Muzhixing/MCU-slave-device/README.md

# 犊牛岛智能投喂车控制工程（main 分支）

## 当前版本说明

`main` 分支目前是 STM32F103C8T6 的正式整合版本。程序已经从地盘、CAN、HWT101、舵机等独立实验入口收拢为单一状态机入口，不再通过宏切换测试程序。

当前版本保留原工程的控制包字段、麦克纳姆轮运动学、航向 PID 公式以及两路步进电机控制参数，并使用已经单独测试过的硬件接线进行整合。

需要特别说明：四路底盘电机、HWT101、舵机、钢丝电机和横杆电机分别完成过单项测试，正式状态机工程也已经通过 Keil 编译，但整车在正式状态机下的联合运行还没有完成实物验证。因此，这个版本是“正式整合与联调起点”，不是最终交付版本。

四路编码器速度 PID 实验仍保存在 `PIDtest` 分支；CAN 专项测试历史保存在 `CANtest` 分支。

## 当前启用的功能

- HC-08 蓝牙串口接收原工程固定 10 字节二进制控制包。
- HWT101 通过 I2C1 读取航向角。
- 四路直流电机采用开环 PWM 驱动，并执行原麦克纳姆轮运动学分解。
- 原 Mulun 航向 PID 输出作为四轮旋转修正量。
- CAN1 驱动两台步进电机：钢丝地址 1，横杆地址 2。
- 钢丝电机上电执行无感归零，程序等待 30 秒后进入正常控制。
- PA7/TIM3_CH2 驱动横向舵机。

当前没有接入正式动作逻辑的部分：

- 水泵和牛奶监测。
- 超声波检测。
- 第二路舵机。
- 原控制包中的 `SW1`、`SW2` 开关字段。

## 上电与状态机流程

正式入口位于 `new_project/User/main.c`，运行以下四个状态：

```text
STATE_INIT
    ↓
初始化蓝牙串口、四路电机、HWT101、舵机和 CAN1
    ↓
配置并使能地址 1 的钢丝步进电机
    ↓
触发钢丝无感归零并等待 30 秒
    ↓
使能地址 2 的横杆步进电机
    ↓
STATE_IDLE
    ↓
读取 HWT101 航向角并等待蓝牙控制包
    ↓
STATE_UART_PARSE
    ↓
解析并执行控制包，然后返回 STATE_IDLE
```

保护逻辑如下：

- 收到第一帧合法控制包之前，四路底盘电机保持停止。
- HWT101 读取失败时，底盘立即停止输出。
- UART、CAN 或初始化过程进入错误状态后，底盘保持停止。
- 当前没有蓝牙控制包超时停车机制；收到控制包后，底盘会持续执行最后一次有效命令。

## 蓝牙串口协议

HC-08 使用 USART2：115200 波特率、8 数据位、无校验、1 停止位。

正式程序只接收原工程固定 10 字节二进制包：

```text
B3 VX VY YAW SERVO LIFT CROSSBAR SW1 SW2 B4
```

| 字节 | 字段 | 当前用途 |
| ---: | --- | --- |
| 0 | `B3` | 固定包头 |
| 1 | `VX` | 底盘前进方向输入 |
| 2 | `VY` | 底盘横移方向输入 |
| 3 | `YAW` | 航向 PID 的绝对目标角度 |
| 4 | `SERVO` | 横向舵机目标角度，程序限幅为 0～180° |
| 5 | `LIFT` | 地址 1 钢丝电机目标位置 |
| 6 | `CROSSBAR` | 地址 2 横杆电机目标位置 |
| 7 | `SW1` | 保留，当前不执行动作 |
| 8 | `SW2` | 保留，当前不执行动作 |
| 9 | `B4` | 固定包尾 |

发送端必须使用 HEX/原始字节模式。例如：

```text
B3 00 00 00 5A 00 00 00 00 B4
```

ASCII 摇杆测试包已经从正式解析流程删除。

## 引脚与接线

### 四路底盘电机

| 电机 | 位置 | PWM | 方向 A | 方向 B |
| --- | --- | --- | --- | --- |
| A | 左前 LF | PA0 / TIM2_CH1 | PB5 | PB12 |
| B | 左后 LB | PA1 / TIM2_CH2 | PB13 | PB14 |
| C | 右前 RF | PA8 / TIM1_CH1 | PB15 | PA4 |
| D | 右后 RB | PA9 / TIM1_CH2 | PB3 | PB4 |

PWM 周期为 999。四路电机当前没有编码器速度闭环，每个轮子的转速差、负载差和机械摩擦不能由底层速度 PID 自动补偿。

### 通信与其他外设

| 功能 | STM32 引脚 | 说明 |
| --- | --- | --- |
| HC-08 | PA2 TX、PA3 RX | USART2，115200，HC-08 TX 接 PA3，RX 接 PA2 |
| HWT101 | PB6 SCL、PB7 SDA | I2C1，100 kHz，器件地址 0x50 |
| CAN1 | PA11 RX、PA12 TX | 必须经过外接 CAN 收发器，不能直接接 CANH/CANL |
| 横向舵机 | PA7 / TIM3_CH2 | 50 Hz，500～2500 us |
| 第二路舵机预留 | PA6 / TIM3_CH1 | 当前不执行动作 |
| SWD | PA13、PA14 | 保留下载和调试 |

HWT101 的 SCL、SDA 需要上拉到 3.3 V。舵机应使用独立 5 V 电源，并与 STM32 共地。CAN 收发器、STM32 和两台步进驱动器必须共地，CANH、CANL 按同名连接；总线两端根据实际拓扑配置 120 Ω 终端电阻。

## 已经完成的单项实验

### 四路底盘电机

- 四台电机均已分别跑通。
- 已完成四路同时正转实验。
- 30% PWM 测试值为 300，PWM 周期为 999。
- 当前正式版本使用开环 PWM，不使用四路编码器速度 PID。

### HWT101

- 已确认 HWT101 可以通过 I2C1 通信。
- 使用 PB6/PB7 读取寄存器 `0x3F` 的两字节航向角数据。
- 当前换算为有符号角度，范围约为 -180°～180°。

### 舵机

- 横向舵机使用 PA7/TIM3_CH2。
- 已实物测试 90°中位、70°和 110°两侧位置，动作正常。

### CAN 步进电机

- 使用外接 CAN 收发器后，横杆和钢丝电机均完成过运动测试。
- 钢丝驱动器地址为 1，横杆驱动器地址为 2。
- 钢丝电机无感归零已经完成实物测试。
- 正式状态机沿用已验证的地址、方向、速度、加速度和归零参数。

## 航向 PID 的真实状态

当前航向 PID 已经接入正式控制链路，但还不能认定为准确、可靠的整车航向闭环。

当前参数保持原工程数值：

```text
Kp = 12
Ki = 2
Kd = 2
积分上限 = 35
输出上限 = 350
积分分离阈值 = 30°
```

已知问题：

1. 数据包中的 `YAW` 是无符号 8 位，只能直接表示 0～255，不能完整表示 -180°～180°或0～359°航向范围。
2. 程序把 `YAW` 当作绝对航向，没有在车辆开始运动时自动锁定当时的 HWT101 航向。
3. PID 的积分和微分公式没有引入采样周期 `dt`，控制效果会随调用频率改变。
4. 没有航向误差死区，也没有对 HWT101 航向数据进行滤波。
5. PID 小角度误差输出可能低于底盘电机实际起转 PWM，表现为小扰动不回正；误差增大后又可能突然产生较大输出。
6. 四个底盘电机是开环控制，轮速不一致会继续影响航向修正效果。
7. 需要通过实车确认 HWT101 正方向和底盘旋转正方向是否一致，否则可能形成正反馈。

因此，当前版本保留了原工程 PID 数据和计算逻辑，方便后续对照调试，但没有把它记录为“航向 PID 已经调试成功”。

## 原协议的限制

- `VX`、`VY` 都是无符号单字节，原生范围为 0～255。
- 电机 PWM 周期为 999，因此控制包直接传递的平移速度最高约为 25.5% PWM。
- 当前协议不能直接表达负的 `VX/VY`，所以不能完整表示后退和反方向横移。
- 停车包如果携带的目标航向与HWT101当前航向不同，航向 PID 仍可能让底盘原地转动。
- `LIFT`、`CROSSBAR` 只有在数值发生变化时才会重新发送 CAN 运动命令。

这些限制来自原工程的数据结构和控制流程。本次整合没有擅自修改协议字段和原控制数据。

## 当前尚未完成的验证

- 正式状态机下的整车联合运行。
- 蓝牙持续控制、断连和控制包超时安全测试。
- 航向 PID 的方向、死区、起转补偿和参数调试。
- 钢丝、横杆和底盘同时运行时的电源与CAN稳定性。
- 长时间运行和异常恢复测试。
- 水泵、牛奶监测、超声波和第二路舵机。

## 编译情况

2026-09-10 使用 Keil MDK ARMCC 5.06 Update 5 对 `new_project/project.uvprojx` 执行全量重新构建：

```text
Program Size: Code=18498 RO-data=310 RW-data=72 ZI-data=2184
0 Error(s), 0 Warning(s)
```

编译成功只证明当前源码可以生成固件，不等于所有模块已经在整车状态下联合测试成功。

## 后续调试顺序

1. 串口输出 `target_yaw`、`current_yaw`、角度误差、PID输出和四轮PWM。
2. 架空底盘，确认HWT101角度正方向与PID旋转修正方向。
3. 解决目标航向的数据范围和初始航向锁定问题。
4. 根据电机实际起转PWM增加死区或起转补偿，再重新调节航向PID。
5. 增加蓝牙控制包超时停车。
6. 完成底盘、舵机、钢丝和横杆的整车联合测试。
7. 最后接入水泵和其他尚未完成测试的外设。

## 工程目录

- `new_project/`：当前 STM32F103C8T6 正式工程。
- `src/`：原工程，用于核对原始逻辑、协议和参数。
- `log/`：每日实验和分支记录。
- `source/`、`new_chap/`：硬件资料、接线图和参考说明。
- `docs/superpowers/`：正式整合设计与执行计划。

Keil 的 `Objects/`、`Listings/` 和构建日志已由 `.gitignore` 排除，不进入 Git 提交。
