Muzhixing/MCU-slave-device/new_project_f407/F407_HAL_Template/docs/hardware/README.md

# 硬件原始资料

- schematic.jpg：用户提供的PCB原理图，接线以网络名核对，不能凭照片颜色判断。
- pcb-front.jpg / pcb-back.jpg：PCB正反面照片。
- fabrication/：原 f407data/牛犊小车 的制板文件及测试网络资料，保持原始内容。
- stepper-menu/：原 pdt 的24张驱动菜单照片，按原文件名排序编号。菜单光标不等于已保存参数；以实机参数为准。

本工程使用脉冲/DIR控制步进电机，不使用CAN。原理图资料与现有实物可能存在装配差异，尤其驱动使能、COM和电源连接应现场确认。水泵未验证工作，不纳入整合功能。
