Muzhixing/MCU-slave-device/docs/superpowers/specs/2026-09-09-original-state-machine-integration-design.md

# 原状态机与已验证硬件整合设计

## 目标

将 `new_project` 从多种实验模式整合为单一正式程序：以原工程状态机和固定 10 字节上位机协议为控制框架，接入新工程已通过实物测试的四路底盘电机、HC-08 UART、CAN 双步进电机及钢丝无感归零功能，并将 HWT101 恢复为原工程 I2C 数据链路。删除新工程中的运行时测试入口和冗余测试代码，但保留有效底层驱动、实验日志、原工程和参考资料。

本次不迁移未经实物验证的硬件参数和动作逻辑。舵机、超声波、水泵和牛奶监测仍属于后续待完成模块，只保留协议字段和状态机扩展位置。

## 范围

### 正式启用的模块

- USART2 + HC-08：接收原始 10 字节二进制控制包。
- I2C1 PB6/PB7：读取 HWT101 地址 `0x50` 的 Yaw 寄存器 `0x3F`。
- 四路直流电机：使用当前已经实物验证的 PWM 通道和方向引脚。
- 麦克纳姆轮运动学：保留原工程四轮分解公式。
- 航向 PID：保留原工程参数、角度归一化、积分分离和输出限幅。
- CAN1 PA11/PA12：500 kbit/s，通过外接收发器连接两台闭环步进驱动器。
- 钢丝电机：地址 1，保留已验证的无感归零和运动协议。
- 横杆电机：地址 2，保留已验证的运动协议。

### 暂不启用的模块

- 超声波液位检测。
- 水泵。
- 牛奶监测及投喂安全联锁。

这些模块的数据字段仍被解析和保存，但不初始化相关外设、不产生硬件动作。状态机保留命名明确的空接口，方便后续逐模块测试后接入。

### 新增实物验证结果（2026-09-10）

- 横向舵机已经完成实物测试，使用 PA7/TIM3_CH2、50 Hz、500~2500 us。
- 正式程序启用横向舵机，固定包中的 `rudder_angle` 直接作为 0~180°目标角度。
- PA6/TIM3_CH1 仅预留给第二路舵机，正式状态机不下发动作。
- 第四路底盘 PWM 已由 PB1 调整为 PA9/TIM1_CH2，并完成编译与独立电机测试程序验证。

### 不进入正式程序的模块

- 编码器底盘闭环。
- 灰度/循迹。
- OLED 显示。
- 独立电机、VOFA、CAN 单次运动及摇杆实验入口。

## 串口控制协议

HC-08 通过 USART2 模拟原上位机，发送固定 10 字节二进制包：

```text
B3 VX VY YAW SERVO LIFT CROSSBAR SW1 SW2 B4
```

| 索引 | 字段 | 当前处理 |
|---:|---|---|
| 0 | `0xB3` | 包头 |
| 1 | `forward_speed` | 更新底盘 `motor_vx` |
| 2 | `horizontal_speed` | 更新底盘 `motor_vy` |
| 3 | `target_angle` | 更新绝对目标航向 `target_yaw` |
| 4 | `rudder_angle` | 控制 PA7/TIM3_CH2 横向舵机，范围限制为 0~180° |
| 5 | `lift_rod` | 字段变化时控制地址 1 钢丝电机 |
| 6 | `horizontal_rod` | 字段变化时控制地址 2 横杆电机 |
| 7 | `switch_one` | 保存，暂不执行 |
| 8 | `switch_two` | 保存，暂不执行 |
| 9 | `0xB4` | 包尾 |

本阶段不改变字段宽度、顺序和原数据含义，不增加校验和，也不把速度字段改为有符号数。ASCII 摇杆包 `[j,LX,LY,RX,RY]` 从正式工程中移除。

## 状态机

正式状态包括：

- `STATE_INIT`
- `STATE_IDLE`
- `STATE_UART_PARSE`
- `STATE_ERROR`

可以保留 `STATE_TASK1`、`STATE_TASK2` 作为后续未完成模块的空扩展点，但它们不产生硬件动作。

### 初始化状态

初始化顺序：

1. 初始化 USART2 和 HC-08 接收中断。
2. 初始化 PB6/PB7 上的 I2C1，并验证 HWT101 地址可应答。
3. 初始化四路底盘 PWM 和方向 GPIO，保持电机停止。
4. 初始化 CAN1、过滤器和接收通知。
5. 初始化双步进电机控制接口。
6. 使用已验证参数启动钢丝无感归零，并保留 30 秒归零等待。
7. 清零底盘速度、目标状态和航向 PID。
8. 进入空闲状态。

初始化失败进入错误状态；错误状态停止四路底盘，并禁止下发新的步进运动命令。

### 空闲状态

空闲状态持续执行以下工作：

1. 检查是否收到完整且合法的 10 字节串口包；有完整包时转入解析状态。
2. 按受控周期读取 HWT101 的 Yaw 寄存器并更新当前角度。
3. 每次成功获得新的 I2C 角度样本后执行一次航向 PID。
4. 使用最新 `motor_vx`、`motor_vy` 和 PID 输出执行四轮麦轮分解。
5. HWT101 地址无应答或寄存器读取失败时停止四轮电机。

I2C 读取使用有限超时，禁止沿用原工程的 `HAL_MAX_DELAY`。读取失败不能返回伪造的 `0°`；必须返回错误状态，由状态机停止底盘。地址、寄存器、字节顺序、角度比例和 PID 数据保持原工程含义。

### 串口解析状态

解析状态完成：

1. 再次验证包头、固定长度和包尾。
2. 复制八个有效字段到正式命令结构体。
3. 更新 `motor_vx`、`motor_vy` 和 `target_yaw`。
4. 仅当 `lift_rod` 与上一条已执行命令不同时，下发地址 1 钢丝命令。
5. 仅当 `horizontal_rod` 与上一条已执行命令不同时，下发地址 2 横杆命令。
6. 将 `rudder_angle` 下发到横向舵机；保存两个开关字段但不产生硬件动作。
7. 返回空闲状态并重新接收下一包。

## 航向控制

删除当前蓝牙实验中的手动旋转状态和以下行为：

```c
target_yaw = current_yaw;
```

正式控制链固定为：

```text
数据包 target_angle
        ↓
绝对 target_yaw
        ↓
HWT101 current_yaw
        ↓
原 Mulun PID
        ↓
旋转修正 omega
        ↓
原麦轮分解
        ↓
四路有符号 PWM
```

PID 参数保持：`Kp=12`、`Ki=2`、`Kd=2`、积分上限 35、输出上限 350、积分分离阈值 30°。

本次不增加最低回正 PWM、不修改PID符号、不修改四轮比例归一化。完成结构整合后，先以抬轮低风险测试确认 HWT101 正方向与实际旋转方向一致，再单独处理电机死区和参数整定。

## 文件调整

### 新增

- `new_project/App/State_Machine.c`
- `new_project/App/State_Machine.h`

### 精简和修改

- `new_project/User/main.c`：删除模式选择，只调用正式状态机。
- `new_project/Hardware/UpperComputer.c/.h`：只保留固定 10 字节协议、正式命令执行和横向舵机字段下发。
- `new_project/Hardware/UART.c/.h`：保留 HC-08 中断接收和必要发送接口。
- `new_project/Hardware/WT101.c/.h`：改为 I2C 寄存器读取，保留原地址、字节顺序和角度换算。
- `new_project/Hardware/Motor.c/.h`：保留实物接线、四轮驱动、麦轮分解和航向 PID 接口。
- `new_project/Hardware/can.c/.h`、`hcan.c/.h`、`Emm_V5.c/.h`、`tower.c/.h`：保留已验证 CAN 和步进协议，移除测试诊断专用接口。
- Keil 工程文件：移除测试源文件，加入正式状态机源文件。

### 从正式新工程删除

- `new_project/App/App_Test.c`
- `new_project/App/App_Test.h`
- `new_project/App/buleteethtest.c`
- `new_project/App/buleteethtest.h`
- `new_project/Tests/`
- `APP_TEST_MODE`、`MAIN_APP_MODE`及其条件编译入口。
- 固定 PWM、VOFA、单电机 PID、CAN 单次运动、ASCII 摇杆等测试逻辑和测试文字输出。

### 明确保留

- `src/` 原工程。
- `log/` 实验记录。
- `source/`、`new_chap/` 接线图、说明书和参考资料。
- 已验证底层驱动。

## 引脚规划

| 功能 | 引脚 |
|---|---|
| HC-08 USART2 | PA2 TX、PA3 RX |
| HWT101 I2C1 | PB6 SCL、PB7 SDA，外接约 4.7 kΩ 上拉到 3.3 V |
| CAN1 | PA11 RX、PA12 TX |
| LF PWM/方向 | PA0；PB5、PB12 |
| LB PWM/方向 | PA1；PB13、PB14 |
| RF PWM/方向 | PA8；PB15、PA4 |
| RB PWM/方向 | PA9；PB3、PB4 |
| 横向舵机 | PA7 / TIM3_CH2 |
| 第二路舵机预留 | PA6 / TIM3_CH1，不下发动作 |

## 安全行为

- 上电和初始化期间四轮保持停止。
- 第一帧有效控制包到达且 HWT101 首次 I2C 读取成功前，不启动底盘。
- HWT101 无应答或寄存器读取失败后停止四轮。
- 非法串口包不覆盖上一条有效命令。
- CAN 初始化失败或归零命令失败时不继续发送步进运动命令。
- 未完成模块不初始化、不动作。

原工程没有通信超时停止策略。本次先保持原数据包的“最后有效命令持续生效”语义，避免蓝牙只发送一次时立即停止；是否增加上位机看门狗作为后续独立安全改动处理。

## 验证

1. 使用临时主机测试验证固定 10 字节包的合法、非法和连续帧解析；测试完成后按需求不把测试目录保留在正式工程。
2. 静态核对原 PID 参数、角度归一化和麦轮公式。
3. 静态核对地址 1 钢丝、地址 2 横杆以及字段变化触发规则。
4. 完整构建 Keil 工程，确认正式源文件列表正确且无测试文件引用。
5. 实物按“串口解析、HWT角度、抬轮PID方向、底盘带载、双步进”顺序验收。
6. 不提交 Keil 中间产物和构建垃圾。

## 完成标准

- 新工程只有一个正式运行入口。
- HC-08 只使用原固定 10 字节协议。
- `target_yaw` 只由数据包 `target_angle` 更新，不被当前角度覆盖。
- 四轮、HWT101、CAN双步进和钢丝归零整合到正式状态机。
- 未完成模块只保留无动作接口。
- 实验入口和冗余测试代码从新工程移除。
- Keil 工程构建通过，并能进入分阶段实物验收。
