Muzhixing/MCU-slave-device/log/20260830.md

# 2026-08-30 工程迁移与 HWT101 调试记录

## 1. 今日工作范围

今天继续在 `E:\project_M\new_project` HAL 工程中进行分阶段移植和硬件验证，原工程 `E:\project_M\src` 继续作为功能与数据逻辑参考，不修改原工程的控制参数和计算逻辑。

本次主要完成和分析的内容包括：

- 核对 HWT101 模块实物、引脚和通信方式；
- 分别测试 HWT101 的 I²C 与 UART 通信；
- 将 HWT101 UART 接收代码接入当前 HAL 测试工程；
- 使用 USART2 将 HWT101 原始数据输出到电脑；
- 分析 WIT 标准通信协议中的发送命令和返回帧；
- 复核新开发板的 USART、I²C、CAN 和板载收发器资源；
- 识别新增照片中的 TJA1050 CAN 总线收发器模块；
- 完成工程构建验证并记录当前硬件故障状态。

## 2. 当前串口资源分配

### 2.1 电脑调试串口

当前继续使用 USART2 作为 USB-TTL 调试输出：

| 功能 | STM32 引脚 | 说明 |
|---|---|---|
| USART2_TX | PA2 | 接 USB-TTL 的 RX |
| USART2_RX | PA3 | 接 USB-TTL 的 TX，可选 |
| RS485-2 DE | PA6 | 输出低电平，禁用板载 RS485 发送 |
| RS485-2 /RE | PA7 | 输出高电平，禁用板载 RS485 接收输出 |

串口参数为：

```text
115200 bps
8 data bits
No parity
1 stop bit
```

### 2.2 HWT101 UART

为了避开开发板 PA9/PA10 上的板载 MAX232 电路，将 USART1 重映射到 PB6/PB7：

| HWT101 | STM32 | 功能 |
|---|---|---|
| VCC | 3.3V | 模块电源 |
| GND | GND | 必须共地 |
| TX | PB7 | USART1_RX |
| RX | PB6 | USART1_TX；只读取时可以暂不连接 |

HWT101 裸板模块对应手册版本为 V23-0705，默认 UART 参数确认为 **115200、8N1**。此前查询到的 9600 bps 参数属于其他封装或型号资料，不适用于当前裸板 HWT101。

## 3. HWT101 UART 测试代码

当前 HAL 工程已经加入 HWT101 UART 原始帧测试：

- 使用重映射 USART1 在 PB7 接收传感器数据；
- 搜索 `0x55` 帧头；
- 每次读取固定 11 字节 WIT 数据帧；
- 对前 10 字节求和并与第 11 字节校验和比较；
- 通过 USART2 将完整原始帧以十六进制输出；
- 接收失败时输出 HAL 状态码。

正常数据示例应类似：

```text
HWT101 UART RAW TEST READY
HWT RAW: 55 52 XX XX XX XX XX XX XX XX XX SUM=OK
HWT RAW: 55 53 XX XX XX XX XX XX XX XX XX SUM=OK
```

其中：

- `55 52` 通常为角速度数据帧；
- `55 53` 通常为角度数据帧；
- `SUM=OK` 表示校验正确；
- `HWT UART ERR=3` 表示 `HAL_TIMEOUT`，即在规定时间内没有收到有效数据。

调整为裸板模块正确的 115200 bps 后，工程已使用 Keil ARMCC 完整重新构建，结果为：

```text
0 Error(s), 0 Warning(s)
```

该结果只能证明代码和工程配置可以正确构建，不能替代传感器实物通信验证。

## 4. WIT 串口协议分析

串口软件中看到的以下数据：

```text
FF AA 27 XX 00
```

是上位机发送给传感器的寄存器读取命令，不是 HWT101 返回的数据：

| 字节 | 含义 |
|---|---|
| FF AA | 上位机命令帧头 |
| 27 | 读取寄存器命令 |
| XX | 要读取的寄存器地址 |
| 00 | 地址高字节 |

例如：

```text
FF AA 27 2E 00
```

表示读取版本号寄存器。传感器正常响应寄存器查询时，应返回以 `55 5F` 开头的 11 字节数据帧。串口工具界面持续显示“发”而没有“收”，说明上位机正在发送查询命令，但没有收到模块响应。

## 5. HWT101 I²C 分析与测试结论

HWT101 同时提供 I²C 接口，引脚为 SCL、SDA、VCC 和 GND。模块 I²C 总线为开漏结构，正常情况下 SCL、SDA 需要通过约 4.7kΩ 电阻上拉至 3.3V。

新开发板默认 I2C1 引脚为：

| 功能 | STM32 引脚 |
|---|---|
| I2C1_SCL | PB6 |
| I2C1_SDA | PB7 |

PB8/PB9 已连接板载 TJA1050 CAN 收发器，不适合继续使用原工程中 I2C1 重映射到 PB8/PB9 的方案。因此本次 I²C 测试改用 PB6/PB7，并检查了硬件上拉、引脚配置、设备地址及寄存器读取流程。

原工程 HWT101 I²C 参数保持为参考：

```text
7位设备地址：0x50
Yaw寄存器：0x3F
I²C速度：100kHz
```

实物测试中仍无法获得正常应答，之前出现的 `HAL_ERROR`、`HAL_BUSY` 或超时均属于通信链路未建立，而不是航向角计算公式问题。

## 6. 当前硬件故障结论

**当前 HWT101 模块出现问题，使用串口和 I²C 都无法进行通信。**

目前已经确认或排查：

- 模块实物为支持 TTL UART 和 I²C 的 HWT101 裸板；
- UART 使用交叉接线，HWT101 TX 接 STM32 RX；
- UART 波特率已按裸板手册改为 115200；
- USART1 已正确重映射到 PB6/PB7；
- I²C 已改用新开发板可用的 PB6/PB7；
- 原工程的 I²C 地址和寄存器逻辑已经核对；
- STM32 工程可以正常构建；
- 上位机能够发送 WIT 查询命令，但没有看到以 `0x55` 开头的传感器返回帧。

因此，当前故障更倾向于以下硬件方向：

1. HWT101 模块供电异常或电源接触不良；
2. 模块 TX 引脚没有输出或模块内部串口状态异常；
3. 模块 I²C 接口损坏或没有正确形成上拉电平；
4. 模块曾被错误供电、反接或受到静电/短路损伤；
5. 当前模块本体已经损坏。

下一步建议直接使用 USB-TTL 单独连接 HWT101，在完全脱离 STM32 的情况下测试 115200 bps 是否存在 `0x55` 返回帧；同时用万用表或示波器检查 VCC、GND、TX 空闲高电平和上电电流。如果独立测试仍无任何返回，应更换一块确认正常的 HWT101 进行对比。

## 7. CAN 收发器模块识别

新增照片中的绿色小板判断为 TJA1050 CAN 总线收发器模块：

- 蓝色两位端子为 CANH/CANL；
- 中间 SOIC-8 芯片为 CAN 物理层收发器；
- 板上 `121` 电阻为 120Ω CAN 终端电阻；
- 四针接口通常为 VCC、TXD、RXD、GND。

该模块用于 MCU CAN 控制器与 CANH/CANL 差分总线之间的物理层转换，不是 USB-TTL、UART 转换器或 RS485 模块，也不能直接用于 HWT101 的 TX/RX 通信。

新 STM32 开发板已经带有 TJA1050 CAN 收发器并占用 PB8/PB9，因此当前方案通常不需要再增加这块外置 CAN 收发器。

## 8. 当前阶段结论

当前阶段已经完成 HWT101 UART 接收代码、原始帧输出、协议格式分析、I²C 与 UART 引脚复核以及工程构建验证。软件侧已经具备继续测试的最小条件，但现有 HWT101 实物在 UART 和 I²C 两种接口下均未建立通信，因此在更换或确认传感器硬件正常之前，不继续迁移 WT101 航向角计算、PID 和整车运动闭环逻辑。

原项目功能和参数继续保留，后续移植仍遵循“每个模块单独测试通过后再进入整合”的原则。
