Muzhixing/MCU-slave-device/log/20260831.md

# 2026-08-31 UART、航向 PID 与蓝牙底盘测试分析记录

## 1. 今日工作范围

今天继续在 `E:\project_M\new_project` HAL 工程中迁移原工程的上位机串口协议、WT101 航向角数据、麦克纳姆轮航向 PID 和四轮运动计算。

本次继续遵循以下约束：

- `E:\project_M\src` 原工程只作为逻辑和数据来源，不修改；
- PID 结构、参数、计算顺序和限幅数据不擅自调整；
- 上位机数据包长度、字段顺序和字段类型保持原样；
- 麦克纳姆轮运动公式保持原样；
- 只对通信接口、目标工程文件组织和新开发板引脚进行 HAL 适配；
- 软件构建通过不能替代 WT101、电机和蓝牙模块的实物测试。

## 2. 当前串口资源分配

### 2.1 上位机及蓝牙串口

上位机或 HC-08 蓝牙串口模块继续复用 USART2：

| 功能 | STM32 引脚 | 连接 |
|---|---|---|
| USART2_TX | PA2 | 接 USB-TTL/蓝牙模块 RX |
| USART2_RX | PA3 | 接 USB-TTL/蓝牙模块 TX |
| RS485-2 DE | PA6 | 保持低电平，禁止板载 RS485 发送 |
| RS485-2 /RE | PA7 | 保持高电平，禁止板载 RS485 接收输出 |

通信参数保持为：

```text
115200 bps
8 data bits
No parity
1 stop bit
```

HC-08 在本次测试中只作为透明串口传输模块，其收发数据与直接使用 USB-TTL 串口等价。

### 2.2 WT101 串口

WT101 继续使用重映射 USART1：

| 功能 | STM32 引脚 | 连接 |
|---|---|---|
| USART1_TX | PB6 | 接 WT101 RX；只读取时可不接 |
| USART1_RX | PB7 | 接 WT101 TX |

通信参数为 115200、8N1，接收固定 11 字节 WIT 数据帧。

## 3. 原上位机串口协议迁移

原工程固定 10 字节二进制数据包保持不变：

```text
B3 forward_speed horizontal_speed target_angle rudder_angle
   lift_rod horizontal_rod switch_one switch_two B4
```

对应结构仍为：

```c
typedef struct
{
    uint8_t header;
    uint8_t forward_speed;
    uint8_t horizontal_speed;
    uint8_t target_angle;
    uint8_t rudder_angle;
    uint8_t lift_rod;
    uint8_t horizontal_rod;
    uint8_t switch_one;
    uint8_t switch_two;
    uint8_t footer;
} UART_Packet_t;
```

USART2 使用接收中断逐字节收集数据，校验包头 `0xB3`、长度 10 和包尾 `0xB4`。解析后仍按原逻辑赋值：

```text
forward_speed    -> motor_vx
horizontal_speed -> motor_vy
target_angle     -> target_yaw
```

舵机、升降杆、水平杆和开关字段继续保留在数据结构中；本阶段只接入底盘控制所需的三个字段，不擅自改变其他字段数值和排列。

## 4. WT101 UART 航向角数据

WT101 角度帧格式为：

```text
55 53 RollL RollH PitchL PitchH YawL YawH VL VH SUM
```

处理流程为：

1. 搜索帧头 `0x55`；
2. 接收完整 11 字节帧；
3. 校验前 10 字节累加和；
4. 只对类型 `0x53` 的角度帧提取 Yaw；
5. 将 `YawL/YawH` 组合成有符号 `int16_t` 原始值；
6. 使用原角度比例换算。

换算公式保持为：

```c
yaw = (float)yaw_raw / 32768.0f * 180.0f;
```

使用 `int16_t` 是为了正确保留 WT101 协议中的负航向角，不改变协议原始数据。

## 5. 原麦克纳姆轮航向 PID 迁移

本次迁移的是原工程 `src\Hardwaer\mulun.c/.h` 中用于四轮底盘航向控制的 PID，不是另一套两轮编码器速度 PID。

PID 结构字段保持为：

```text
integral
last_error
p / i / d
integral_max
output_max
```

所有原始参数保持不变：

| 参数 | 数值 |
|---|---:|
| P | 12.0 |
| I | 2.0 |
| D | 2.0 |
| 积分上限 | 35.0 |
| 输出上限 | 350.0 |
| 积分分离阈值 | 30.0° |

计算流程保持为：

```text
目标角度与当前角度归一化
        ↓
计算 [-180°, 180°] 内的最短角度误差
        ↓
误差小于 30° 时进行积分
        ↓
积分限幅 ±35
        ↓
计算比例、积分和微分项
        ↓
PID 输出限幅 ±350
```

## 6. 原四轮运动计算

原麦克纳姆轮运动公式保持不变：

```c
speed_lf = vx - vy + omega;
speed_rf = vx + vy - omega;
speed_lb = vx + vy + omega;
speed_rb = vx - vy - omega;
```

其中：

- `vx` 控制前进和后退；
- `vy` 控制左右平移；
- `omega` 为航向 PID 产生的旋转修正量；
- 四个轮速继续交给当前已经验证的四路 HAL 电机接口。

该公式本身支持前后、左右、斜向和旋转组合，可以实现 360° 任意方向移动。例如 `vx` 与 `vy` 同时非零时，小车会沿相应斜向运动。

## 7. uint16_t、uint32_t 与 int32_t 决策

原封装函数为：

```c
void mecanum_with_heading_control(uint16_t vx,
                                  uint16_t vy,
                                  float target_yaw,
                                  float current_yaw);
```

`uint16_t` 和 `uint32_t` 都是无符号类型，不能表示后退或反方向平移所需的负速度。将 `uint16_t` 改成 `uint32_t` 不能解决方向问题，负数还可能被转换为很大的正数。

底层函数已经使用正确的有符号类型：

```c
void mecanum_move(int32_t vx, int32_t vy, float omega);
```

因此本次确定：

- 不修改原 PID 结构和运动公式；
- 不将速度改成 `uint32_t`；
- 后续蓝牙测试在独立测试文件中使用 `int32_t vx` 和 `int32_t vy`；
- 独立计算原 PID 输出 `omega` 后，直接调用原 `mecanum_move()`；
- 这样可以保留原工程逻辑，同时完整表达正负运动方向。

## 8. 江协科技蓝牙串口摇杆资料分析

`source\蓝牙串口信息` 中的 README 和截图确认，江协科技蓝牙串口小程序的摇杆使用 ASCII 文本数据包：

```text
[joystick,左摇杆X,左摇杆Y,右摇杆X,右摇杆Y]
```

启用短格式后为：

```text
[j,左摇杆X,左摇杆Y,右摇杆X,右摇杆Y]
```

示例：

```text
[j,0,-100,97,23]
```

数值可以为负数，因此单片机端必须以有符号类型解析。数据包使用 `[` 和 `]` 确定边界，使用逗号分隔字段。

### 8.1 已确定的摇杆功能

根据本次最终要求，摇杆定义为：

| 摇杆数据 | 功能 |
|---|---|
| 左摇杆 X | 左转或右转，并转换为航向 PID 的目标角度变化 |
| 左摇杆 Y | 暂不使用 |
| 右摇杆 X | 左右平移分量 `vy` |
| 右摇杆 Y | 前进/后退分量 `vx` |

控制数据流确定为：

```text
左摇杆 X
    -> 更新 target_yaw
    -> PID_Mulun_Calc(target_yaw, current_yaw)
    -> omega

右摇杆 X/Y
    -> int32_t vy/vx

vx + vy + omega
    -> mecanum_move()
    -> 四轮电机
```

因此：

- 左摇杆负责左右旋转和改变目标航向；
- 右摇杆负责前后、左右以及所有斜向平移；
- 平移过程中仍通过 WT101 和原 PID 修正航向；
- 原麦轮计算可以满足斜向和 360°平移要求；
- 蓝牙模块继续复用 USART2，不新增通信硬件接口。

### 8.2 蓝牙测试文件决策

后续独立测试文件名称按要求确定为：

```text
new_project\App\buleteethtest.c
new_project\App\buleteethtest.h
```

这两个文件当前尚未编写。本次只完成蓝牙资料读取、协议确认、方向映射、PID接入方式和数据类型决策，不能将蓝牙实机控制写成已经测试完成。

## 9. 已完成的软件验证

当前已经加入主机回归测试，逐项确认：

- WT101 `+90°` 和 `-90°` 航向角换算；
- 错误校验和数据帧拒绝；
- PID 的 P/I/D、积分、微分、环绕角度和限幅结果；
- 原 10 字节上位机数据包的所有字段；
- `motor_vx`、`motor_vy` 和 `target_yaw` 的赋值；
- 四轮麦克纳姆运动公式；
- PID 输出正负号进入四轮方向控制；
- UART、WT101、PID 和电机之间的数据调用顺序。

主机测试结果为：

```text
PASS: WT101 conversion and original Mulun PID calculations
PASS: UART and motor migration behavior
PASS: original ten-byte upper-computer UART data flow
PASS: selectable UART and motor application flows
PASS: HWT101 module UART baud is 115200
```

Keil ARMCC 完整构建结果为：

```text
Program Size: Code=11590 RO-data=310 RW-data=28 ZI-data=1972
0 Error(s), 0 Warning(s)
```

链接映射已经确认以下功能实际进入最终固件：

- USART2 中断接收；
- 原 10 字节数据包解析；
- WT101 角度帧解析；
- `PID_Mulun_Init()` 和 `PID_Mulun_Calc()`；
- `mecanum_move()`；
- `mecanum_with_heading_control()`；
- 当前集成控制入口。

## 10. 当前结论与下一步

当前软件已经完成原上位机 UART、WT101 UART 航向角、原航向 PID 和四轮运动计算的迁移，并通过主机数值测试及 Keil 构建验证。原工程 `src` 未修改。

当前尚未完成的实物验证包括：

1. WT101 实际连续返回正确正负航向角；
2. PID 转向方向是否与车体安装方向一致；
3. PID 灵敏度、振荡和超调情况；
4. 四轮同时运行时的斜向轨迹；
5. HC-08 与江协科技小程序的连续摇杆数据接收；
6. `buleteethtest.c/.h` 独立蓝牙测试代码及整车测试。

下一阶段应先实现独立蓝牙测试模式，再按“停车、前后、左右、四个斜向、原地左右转、移动中航向保持”的顺序逐项进行低速实车测试。在获得实车数据前，不调整原 PID 参数。
