Muzhixing/MCU-slave-device/log/20260910.md

# 2026-09-10 实验记录

## HWT101

今天先把 HWT101 改成了 IIC 通信。接线为 PB6-SCL、PB7-SDA，使用 I2C1、100 kHz，读取 0x3F 的航向角数据。串口只负责把读取结果发给蓝牙，不再占用 HWT101 的串口。当前读取流程已经确认可用。

## 四路底盘电机

完成了四路电机 30% PWM 正转测试程序。PWM 周期仍为 999，测试值为 300，不使用编码器 PID，也不启用 HWT101 航向修正。

当前接线如下：

| 电机 | PWM | A 方向 | B 方向 |
| --- | --- | --- | --- |
| A / 左前 | PA0，TIM2_CH1 | PB5 | PB12 |
| B / 左后 | PA1，TIM2_CH2 | PB13 | PB14 |
| C / 右前 | PA8，TIM1_CH1 | PB15 | PA4 |
| D / 右后 | PA9，TIM1_CH2 | PB3 | PB4 |

D 电机 PWM 从原来的 PB1 调整到了 PA9，这样 PA6、PA7 可以完整留给两个舵机。程序已通过主机测试和 Keil 编译；实际装车时仍要再次核对四个轮子的正转方向。

## 舵机测试

单独测试了原工程的横向舵机，不启动电机、CAN 和 HWT101。横向舵机信号接 PA7（TIM3_CH2），保持原工程 50 Hz PWM 和 500~2500 us 脉宽范围。

测试动作循环为：中位 90°、左转 20°（70°）、回中 90°、右转 20°（110°）、回中 90°，每个位置保持 2 秒。

舵机使用独立 5 V 电源，舵机电源地必须和 STM32 的 GND 共地，不能直接使用开发板 3.3 V 给舵机供电。

实物测试已经完成，90°中位、70°和110°两侧动作正常。正式程序使用数据包中的 `rudder_angle` 控制该舵机。

## 正式状态机整合

在上述单项测试基础上开始整合正式程序。主函数不再选择实验模式，只运行 INIT、IDLE、UART_PARSE 和 ERROR 四个状态。蓝牙只接收原来的10字节二进制包；ASCII摇杆实验包已从正式解析流程移除。

钢丝地址1，沿用无感归零参数并等待30秒；横杆地址2。底盘只有在收到第一帧合法控制包且HWT101读取成功后才运行，HWT101读取失败立即停止四轮。D电机最终使用PA9，避免占用CAN的PA11/PA12和舵机的PA6/PA7。
