Muzhixing/MCU-slave-device/log/main.md

# main分支说明

## 当前定位

主分支已由多个互斥实验入口整合为单一正式状态机。代码沿用原工程的10字节上位机数据包、麦克纳姆轮公式、Mulun航向PID和步进运动参数，同时使用新工程已经完成实物测试的引脚与通信方式。

## 已接入功能

- HC-08：PA2/PA3，USART2，115200、8N1。
- HWT101：PB6/PB7，I2C1，地址0x50，Yaw寄存器0x3F。
- 四路开环底盘：PWM PA0、PA1、PA8、PA9。
- CAN双步进：PA11/PA12，500 kbit/s，钢丝地址1、横杆地址2。
- 钢丝上电无感归零：正式控制前等待30秒。
- 横向舵机：PA7/TIM3_CH2，50 Hz，500～2500 us。

## 正式运行逻辑

上电进入`STATE_INIT`，初始化所有已验证外设并保持底盘停止。钢丝归零完成后进入`STATE_IDLE`。串口收到合法的`B3...B4`十字节包时进入`STATE_UART_PARSE`，更新底盘目标、舵机和两路步进命令，再回到空闲状态。

空闲状态每10 ms读取一次HWT101。只有已经收到合法控制包并读取到有效航向角时，才执行原航向PID和麦轮分解。I2C读取失败时四轮立即停止，不使用伪造的0°数据。

## 当前引脚

| 功能 | 引脚 |
| --- | --- |
| 电机A | PA0；PB5、PB12 |
| 电机B | PA1；PB13、PB14 |
| 电机C | PA8；PB15、PA4 |
| 电机D | PA9；PB3、PB4 |
| HC-08 | PA2、PA3 |
| HWT101 | PB6、PB7 |
| 横向舵机 | PA7 |
| 第二路舵机预留 | PA6 |
| CAN1 | PA11、PA12 |

## 尚未完成

超声波、水泵、牛奶监测和第二路舵机没有接入正式动作。相关串口字段可以保留，但当前不会初始化或驱动这些硬件。

`PIDtest`保留四路编码器速度PID实验；`CANtest`保留CAN专项调试历史。
