Muzhixing/MCU-slave-device/log/20260907.md

# 2026-09-07 CAN步进电机测试记录

## 今天完成的内容

今天在 `CANtest` 分支完成了STM32F103C8T6通过外接TJA CAN收发器控制闭环步进电机的测试。横杆电机已经能够通过CAN运动，钢丝升降电机恢复出厂并重新设置后，也完成了地址1、正方向、5 mm低速移动测试。

最后确认CAN物理层、500 kbit/s通信参数、Emm V5协议、钢丝电机地址和毫米到脉冲的换算都能正常配合。当前安全测试程序只启动钢丝电机，不会同时启动横杆。

## 分支和工程范围

- Git分支：`CANtest`
- 分支起点：`ee53ff3`
- 原工程：`src`
- 当前测试工程：`new_project`
- 主控：STM32F103C8T6
- 步进驱动：X42系列闭环驱动板，Emm V5协议
- CAN收发器：外接TJA模块
- 串口：USART2，115200，8N1，用于蓝牙/USB-TTL输出调试信息

这个分支只用于CAN步进电机功能验证，没有改动原工程 `src` 中的运动参数和控制流程。

## 成功时的接线

### STM32与TJA模块

| STM32F103C8T6 | TJA模块 | 说明 |
| --- | --- | --- |
| PA12 / CAN1_TX | TXD | STM32向CAN收发器发送逻辑数据 |
| PA11 / CAN1_RX | RXD | STM32接收CAN收发器输出的数据 |
| 5V | VCC | TJA模块供电 |
| GND | GND | STM32与TJA模块共地 |

### TJA模块与电机CAN模块

| TJA模块 | 电机CAN模块 | 说明 |
| --- | --- | --- |
| CANH | CHAN | CAN高线，模块丝印中的 `CHAN` 按CANH使用 |
| CANL | CHAL | CAN低线，模块丝印中的 `CHAL` 按CANL使用 |

电机驱动器使用自己的动力电源。CANH和CANL使用双绞线连接；总线两端按需要保留120欧终端电阻。不能把PA11、PA12直接接到CANH、CANL，中间必须经过TJA收发器。

### 调试串口

| STM32F103C8T6 | 蓝牙/USB-TTL |
| --- | --- |
| PA2 / USART2_TX | RXD |
| PA3 / USART2_RX | TXD |
| GND | GND |

## 钢丝电机恢复后的驱动器设置

恢复出厂以后先断电重启，再重新执行编码器校准。校准时尽量让电机空载或轻载，避免钢丝被拉紧。

| 菜单项 | 本次设置 | 作用 |
| --- | --- | --- |
| MotType | 1.8° | 对应当前电机和每圈3200脉冲的计算 |
| Cal | 执行一次 | 重新标定编码器和电机参数 |
| P_Pul | PUL_FOC | 闭环FOC控制 |
| P_Serial | CAN1_MAP | 将通信接口设置为CAN |
| En | Hold | 不依赖外部EN引脚，仍可通过协议使能 |
| MStep | 16 | 1.8°电机每圈3200脉冲 |
| MPlyer | Enable | 打开内部细分插补 |
| CAN_Baud | 500000 | 与STM32程序一致 |
| ID_Addr | 1 | 原工程钢丝/升降电机地址 |
| Checksum | 0x6B | 与Emm V5代码一致 |
| Response | Both | 返回接收确认和到位信息 |
| S_Vel_IS | Disable | 速度值不缩小10倍 |
| O_POT_En | Disable | 本次安全测试暂时关闭上电自动回零 |

原工程地址保持为：钢丝升降电机地址1，横杆电机地址2。之前测试中钢丝地址曾设置为3，本次已经重新统一到原工程的地址1。

## CAN配置

STM32时钟为72 MHz，APB1为36 MHz。CAN参数为：

```text
Prescaler = 4
SJW       = 1 TQ
BS1       = 13 TQ
BS2       = 4 TQ
Mode      = Normal
```

CAN位速率计算：

```text
36 MHz / 4 / (1 + 13 + 4) = 500 kbit/s
```

程序使用扩展帧。扩展帧ID由电机地址和分包序号组成：

```text
ExtId = (address << 8) | packet_index
```

钢丝电机地址为1，因此第一帧ID为 `0x100`，第二帧ID为 `0x101`。

## 本次测试数据

本次安全测试调用：

```c
Emm_V5_En_Control(1U, true, false);

Rail_StepMotor_ControlByMM(
    5U,       // 移动5 mm
    1U,       // CAN地址1
    1U,       // 按原工程保留的钢丝正方向
    30U,      // 30 RPM
    5U,       // 加速度档位5
    true,     // 按原工程保留的位置模式标志
    false     // 不等待多机同步
);
```

丝杠参数沿用原工程：

```text
每圈脉冲数 = 3200
丝杠导程   = 4 mm/圈
每毫米脉冲 = 3200 / 4 = 800
5 mm脉冲数 = 5 × 800 = 4000 = 0x00000FA0
```

### 使能命令

Emm V5完整命令：

```text
01 F3 AB 01 00 6B
```

经过当前CAN分包后：

```text
扩展ID 0x100，DLC 5
数据 F3 AB 01 00 6B
```

### 5 mm位置命令

Emm V5完整命令：

```text
01 FD 01 00 1E 05 00 00 0F A0 01 00 6B
```

字段说明：

```text
01          地址1
FD          位置模式功能码
01          方向1
00 1E       速度30 RPM
05          加速度5
00 00 0F A0 脉冲数4000
01          原工程位置模式标志
00          不使用多机同步触发
6B          固定校验字节
```

经过当前CAN分包后：

```text
扩展ID 0x100，DLC 8，数据 FD 01 00 1E 05 00 00 0F
扩展ID 0x101，DLC 5，数据 FD A0 01 00 6B
```

## 代码对应关系

- `new_project/User/main.c`：钢丝电机上电安全测试入口，只发送一次5 mm命令。
- `new_project/Hardware/can.c`：CAN1初始化，PA11/PA12，500 kbit/s。
- `new_project/Hardware/hcan.c`：CAN过滤、接收、扩展帧ID和Emm命令分包发送。
- `new_project/Hardware/Emm_V5.c`：保留原Emm V5使能、位置、停止和回零命令格式。
- `new_project/Hardware/tower.c`：保留原工程毫米到脉冲的换算。
- `new_project/Hardware/UpperComputer.c`：保留原上位机字段到横杆、升降电机命令的映射。
- `new_project/Tests/test_can_stepper_motion.c`：检查原工程两个电机的地址、方向、速度、加速度和脉冲数没有改变。

## 实验结果

1. 钢丝电机恢复出厂后，仅恢复CAN波特率和地址还不够，必须重新选择电机类型并执行 `Cal` 校准。
2. 配置 `P_Serial=CAN1_MAP`、`CAN_Baud=500000`、`ID_Addr=1`、`Checksum=0x6B` 后，钢丝电机能够接收当前工程的CAN命令。
3. 本次地址1、方向1、30 RPM、加速度5、5 mm移动测试成功。
4. 原工程的丝杠换算 `800脉冲/mm` 与驱动器1.8°、16细分设置匹配。
5. 外接TJA收发器使用PA11/PA12可以正常工作，证明之前的问题不在Emm V5运动数据本身，而在CAN物理层、驱动器通信映射或恢复后的参数没有统一。
6. 当前仍关闭上电自动回零。以后恢复自动回零前，需要单独确认回零方向、机械端点以及无感回零的电流和时间阈值，不能直接使用未经验证的数值。

## 当前状态

当前程序适合作为钢丝电机恢复设置后的安全验收程序。确认5 mm重复运动和方向完全正确后，再把测试速度恢复到原工程的100 RPM，并重新接入横杆地址2和上位机控制流程。
