Muzhixing/MCU-slave-device/new_project_f407/README.md

唯一工程入口：[F407_HAL_Template/README.md](F407_HAL_Template/README.md)。
