Muzhixing/MCU-slave-device/source/蓝牙串口信息/readme.txt

摇杆
摇杆可在用户拖动操作后，向蓝牙串口模块发送规定的数据包，用于设备操控、小车遥控等功能。
点击右上角的“编辑”按钮，可以配置摇杆功能。在编辑状态下，点击指定摇杆，可以弹出指定摇杆的配置窗口，在此窗口中，可以配置摇杆的多项信息，具体如下：
形状样式：可设置为圆形或方形。两者的区别是：方形摇杆可以在横向和纵向同时达到最大值而圆形摇杆不行，但圆形摇杆可以保证任何方向摇杆值与原点之间的最大距离相同。
横向最大值：用于修改摇杆横向滑到最大处的摇杆值。
横向步距：用于修改摇杆横向滑动的步距。
纵向最大值：用于修改摇杆纵向滑到最大处的摇杆值。
纵向步距：用于修改摇杆纵向滑动的步距。
配置好摇杆后，在滑动摇杆时，相应的数据包就会发送至蓝牙串口模块，发送信息会显示在“发送信息展示区”。此处目前仅支持以规定的数据包格式进行发送，即：[joystick,左摇杆横向值,左摇杆纵向值,右摇杆横向值,右摇杆纵向值]，值的范围取决于对应摇杆的配置。例如：[joystick,0,100,-50,0]，表示左侧摇杆横向值为0，纵向值为100，右侧摇杆横向值为-50，纵向值为0。
数据包支持使用短格式，若在设置中勾选“数据包使用短格式”，则：“joystick”替换为“j”。
摇杆向右或向上滑动时，值为正，向左或向下滑动时，值为负。若摇杆设置中的“横向最大值”或“纵向最大值”设置为负数，则可以反转值的极性。
滑动摇杆时，数据包每隔一段时间（由设置里的数据包发送间隔指定）发送一次，避免发送过快，导致接收方处理不过来。
数据包解析方法
单片机端作为接收方，需要对数据包进行解析，才能拿到指定的数据。接收数据包时，可以通过“[”和“]”确定数据包的开始和结束，得到方括号内的字符串。随后解析字符串，使用strtok函数可以用逗号分割字符串，使用strcmp函数可以判断字符串是否相等，使用atoi或者atof函数可以把字符串形式的数值转换为变量形式。
