Muzhixing/MCU-slave-device/new_project_f407/F407_HAL_Template/firmware/README.md

# 固件发布文件

本目录HEX由本工程2026-10-26清理后全量Rebuild生成。校验见SHA256SUMS，构建日志见../docs/validation/build.log。
目标STM32F407VET6，HSE8MHz，Keil ARMCC5。未在此次整理中烧录。
重新修改源码后应重新构建、复测并更新本目录与校验；不能把旧发布HEX当作最新源码结果。
