Muzhixing/MCU-slave-device/source/STM32F103C8T6D485-1.pdf

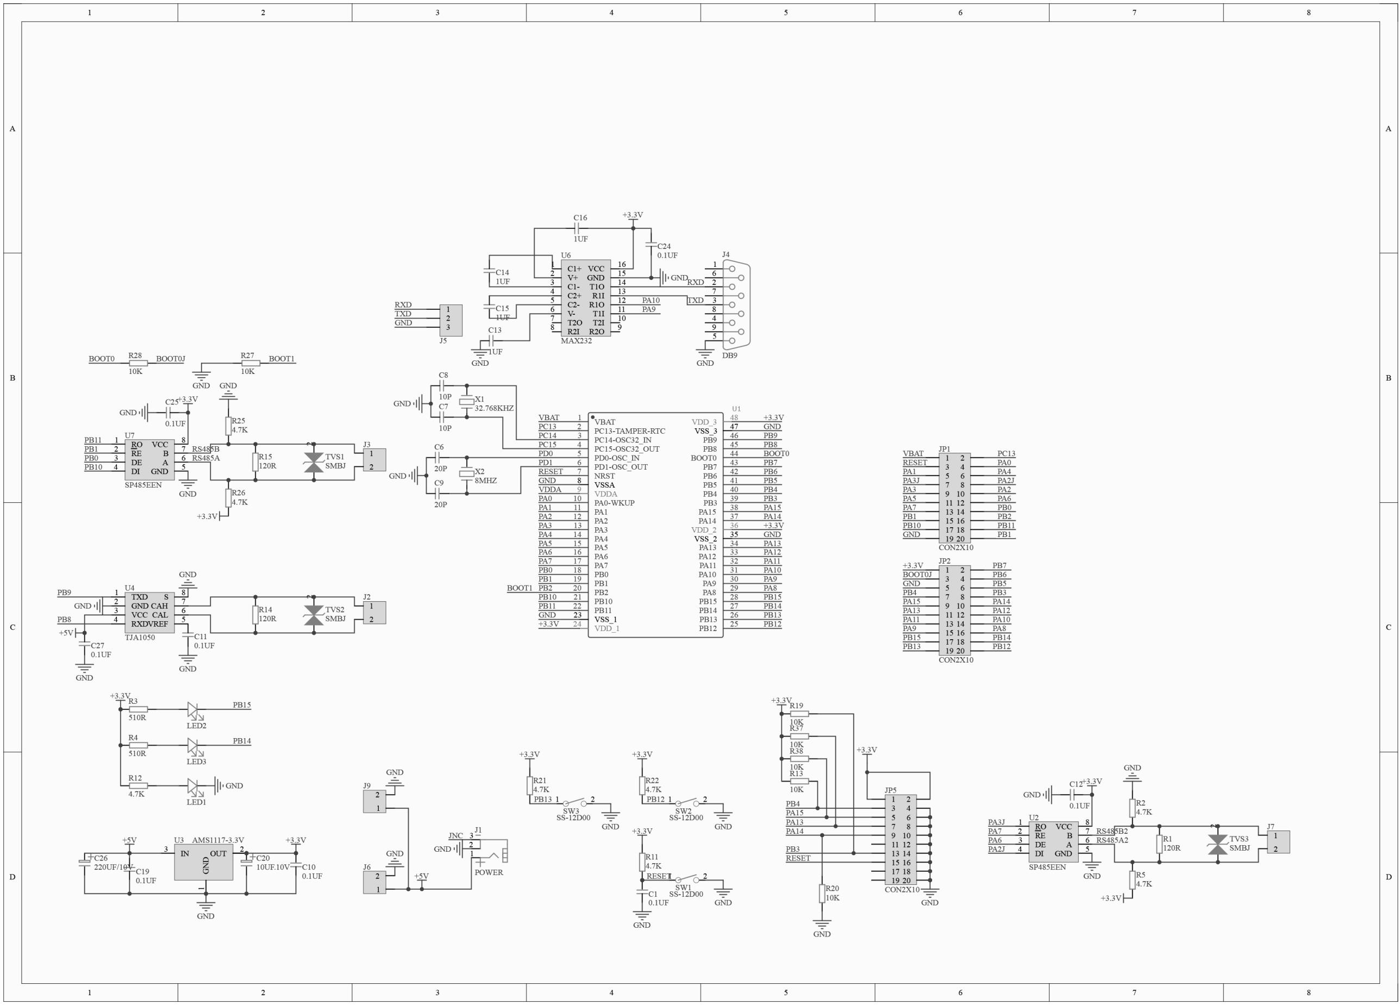
[picture p3: page 1]
