Muzhixing/MCU-slave-device/source/原理图/STM32F103C8T6D485-1.pdf

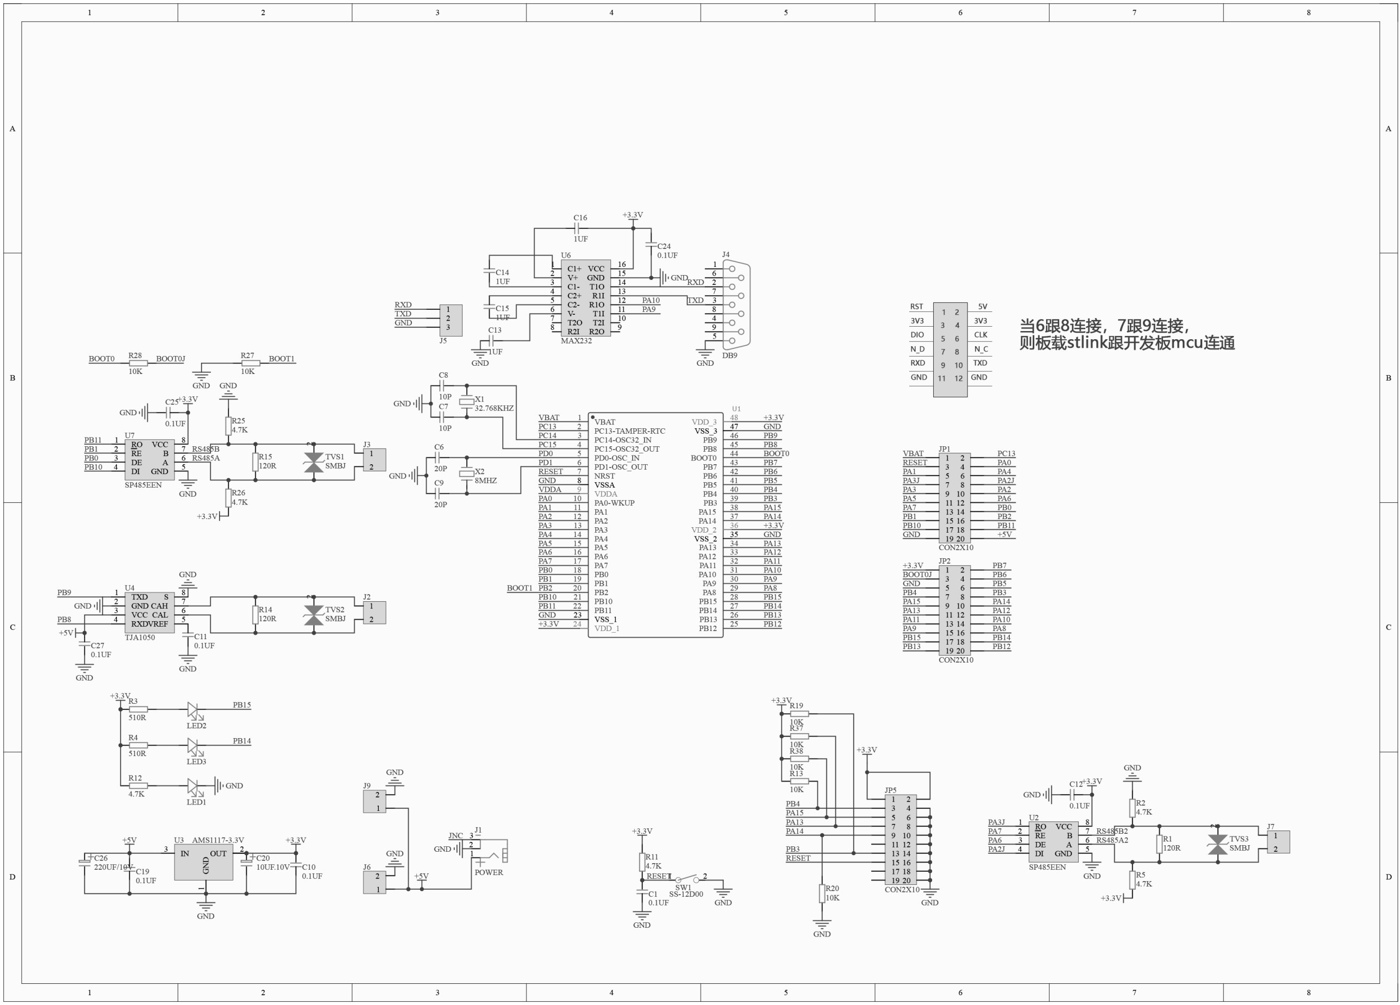
[picture p4: page 1]
