Muzhixing/MCU-slave-device/new_project_f407/F407_HAL_Template/docs/hardware/stepper-menu/20.jpg

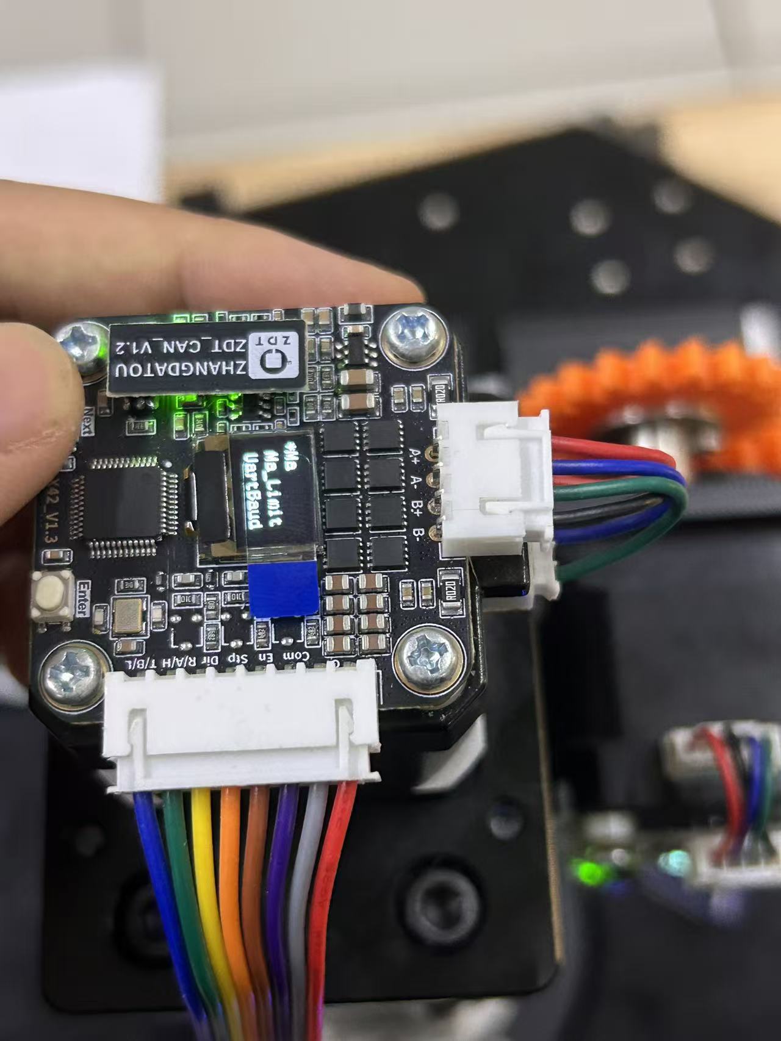
new_project_f407/F407_HAL_Template/docs/hardware/stepper-menu/20.jpg
