Muzhixing/MCU-slave-device/source/D24A.png

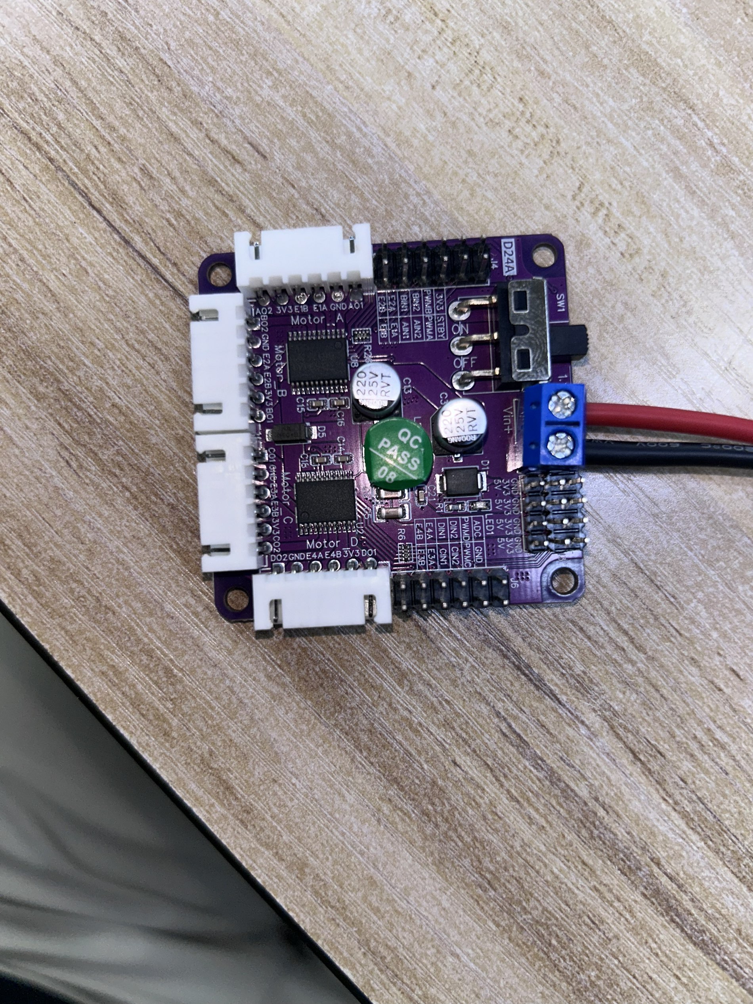
source/D24A.png
