Muzhixing/MCU-slave-device/source/HWT101.jpg

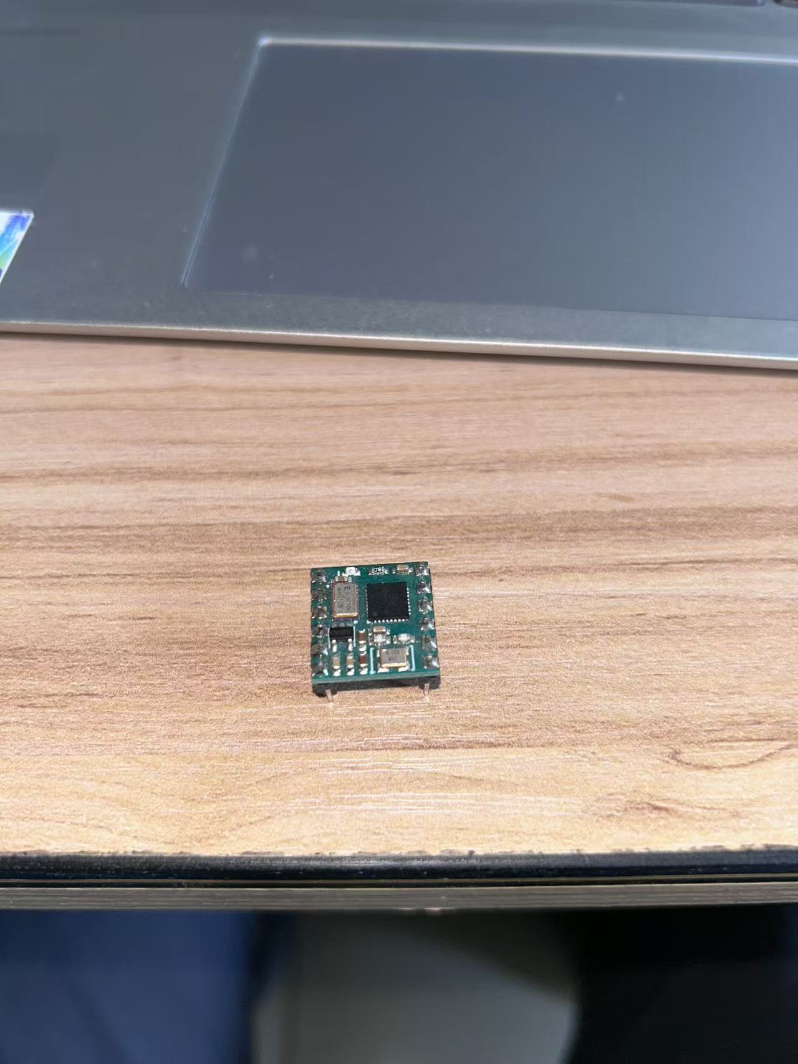
source/HWT101.jpg
