Muzhixing/MCU-slave-device/source/HWT101B.jpg

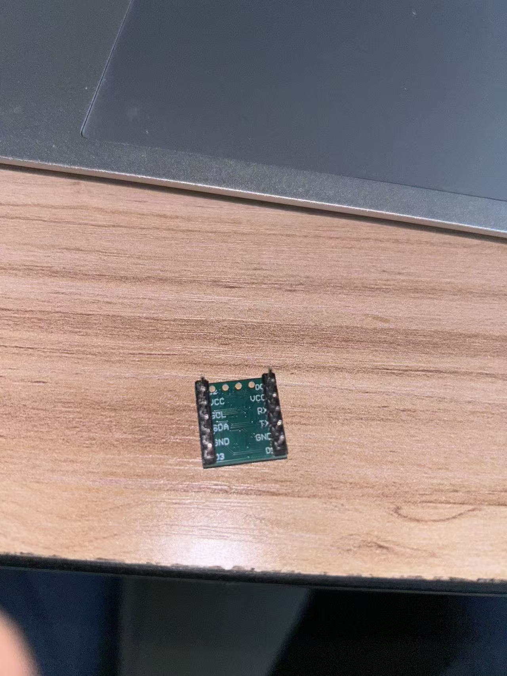
source/HWT101B.jpg
