Muzhixing/MCU-slave-device/source/motor.png

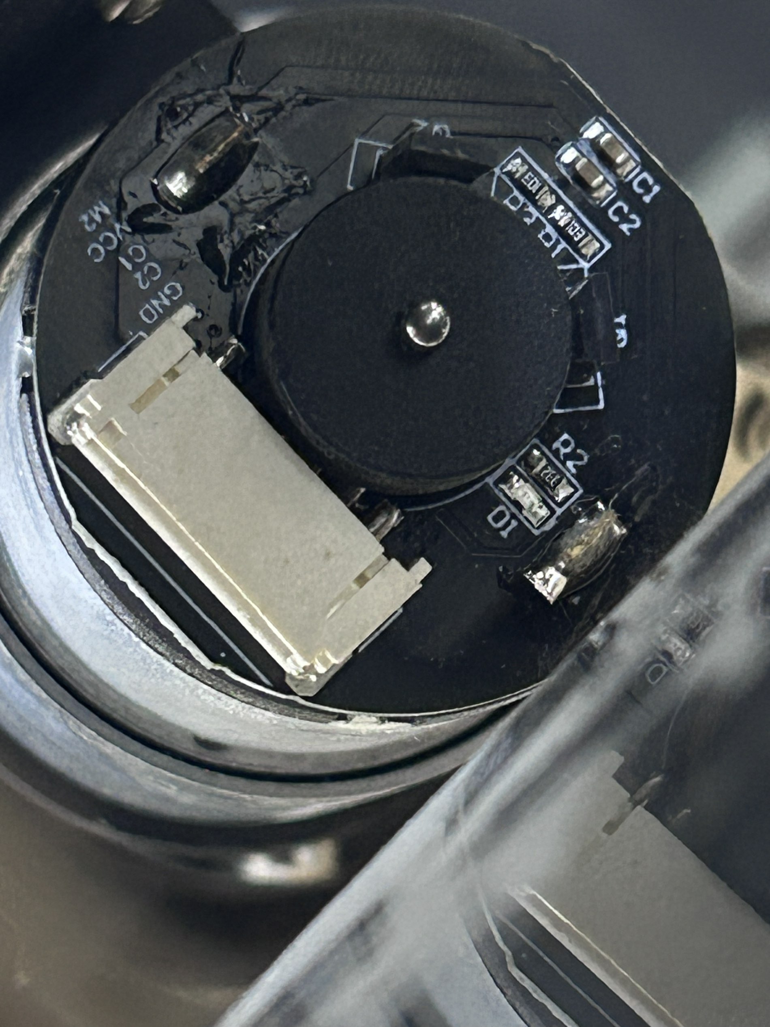
source/motor.png
