Muzhixing/MCU-slave-device/source/stm32c8t6.png

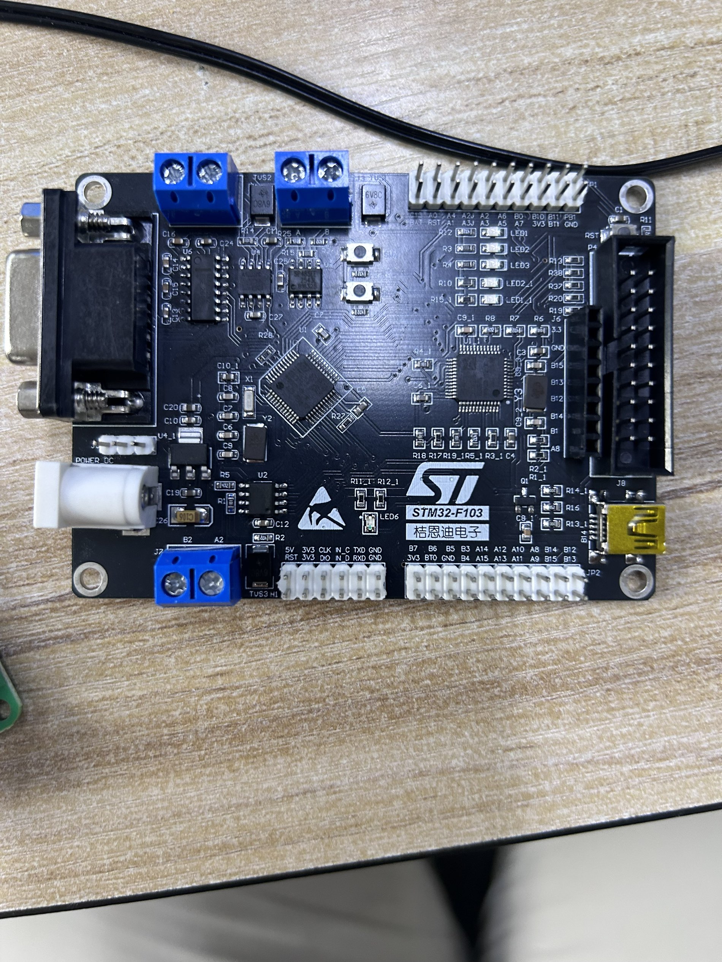
source/stm32c8t6.png
