Muzhixing/MCU-slave-device/source/tupai.jpg

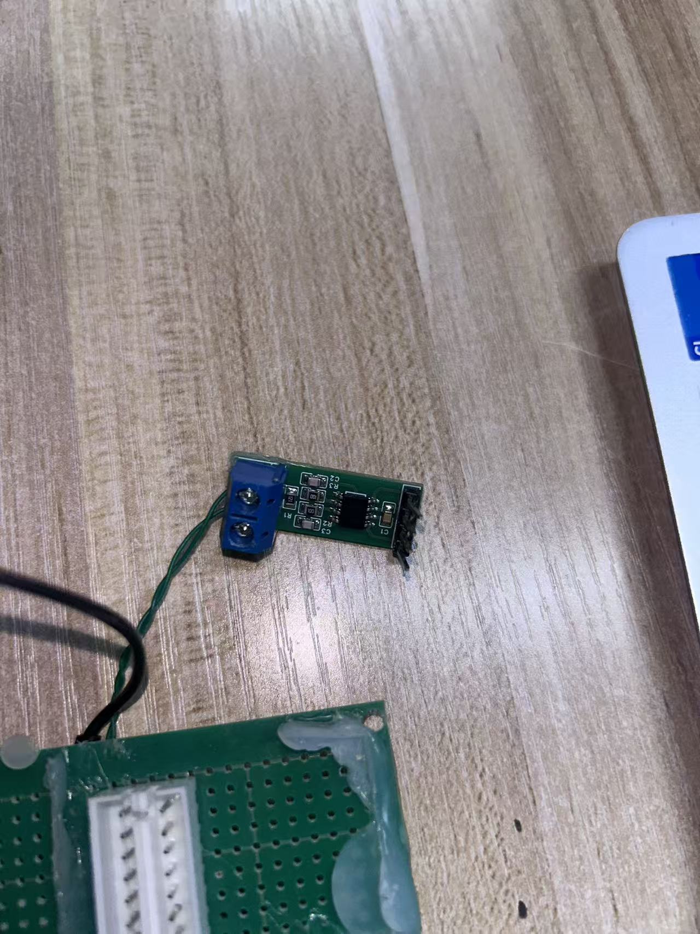
source/tupai.jpg
