Muzhixing/MCU-slave-device/source/上位机.png

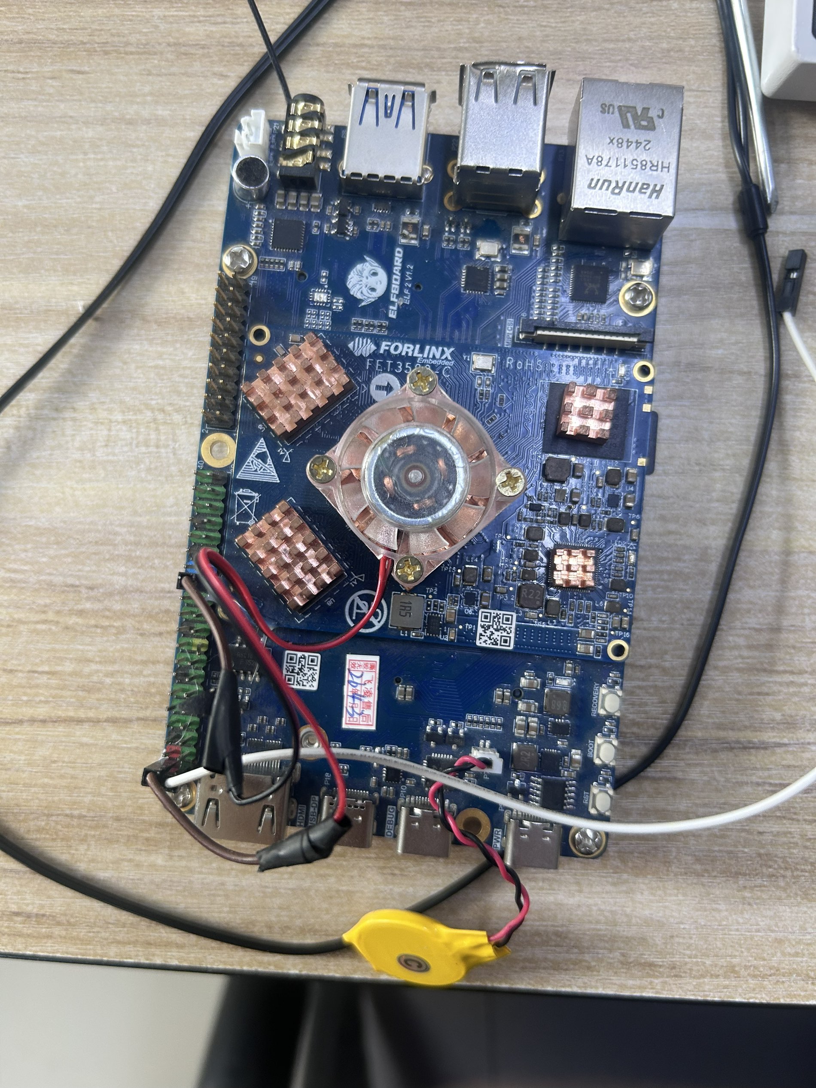
source/上位机.png
