Muzhixing/MCU-slave-device/source/蓝牙串口信息/00e46cf16b4b5d86f79c88b318b47ef7.jpg

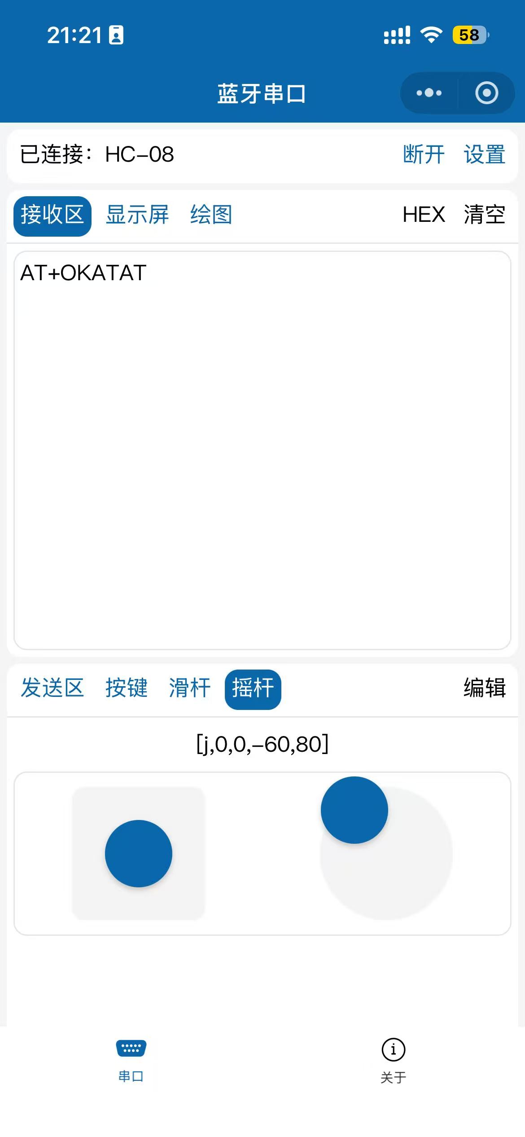
source/蓝牙串口信息/00e46cf16b4b5d86f79c88b318b47ef7.jpg
