Muzhixing/MCU-slave-device/source/蓝牙串口信息/9a2561da734351ed37ddf195a6f66786.jpg

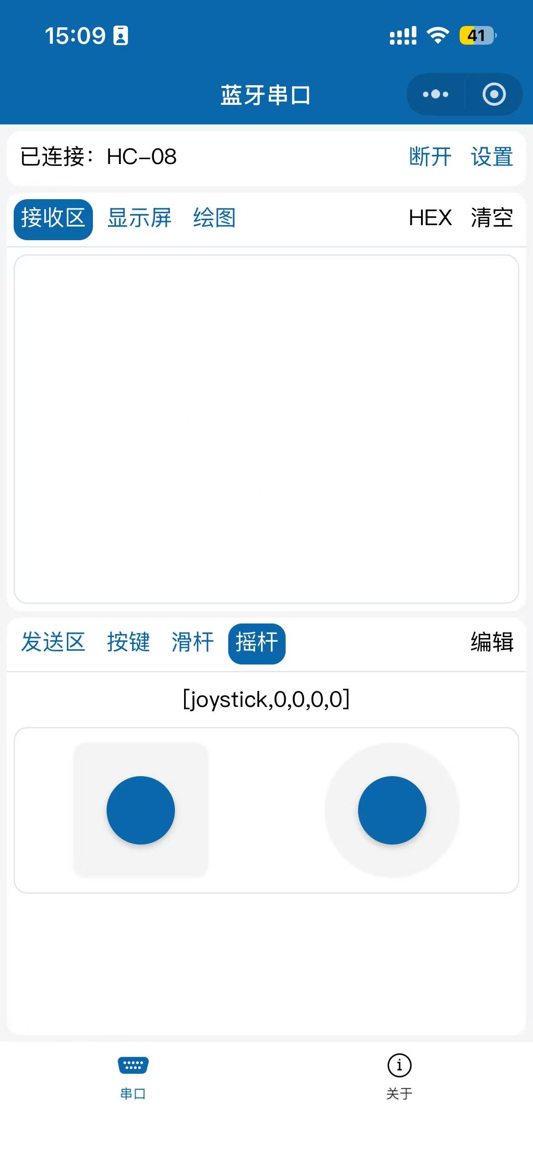
source/蓝牙串口信息/9a2561da734351ed37ddf195a6f66786.jpg
