Muzhixing/MCU-slave-device/source/蓝牙串口信息/42b49e189cae356d66ca0799c48181c1.png

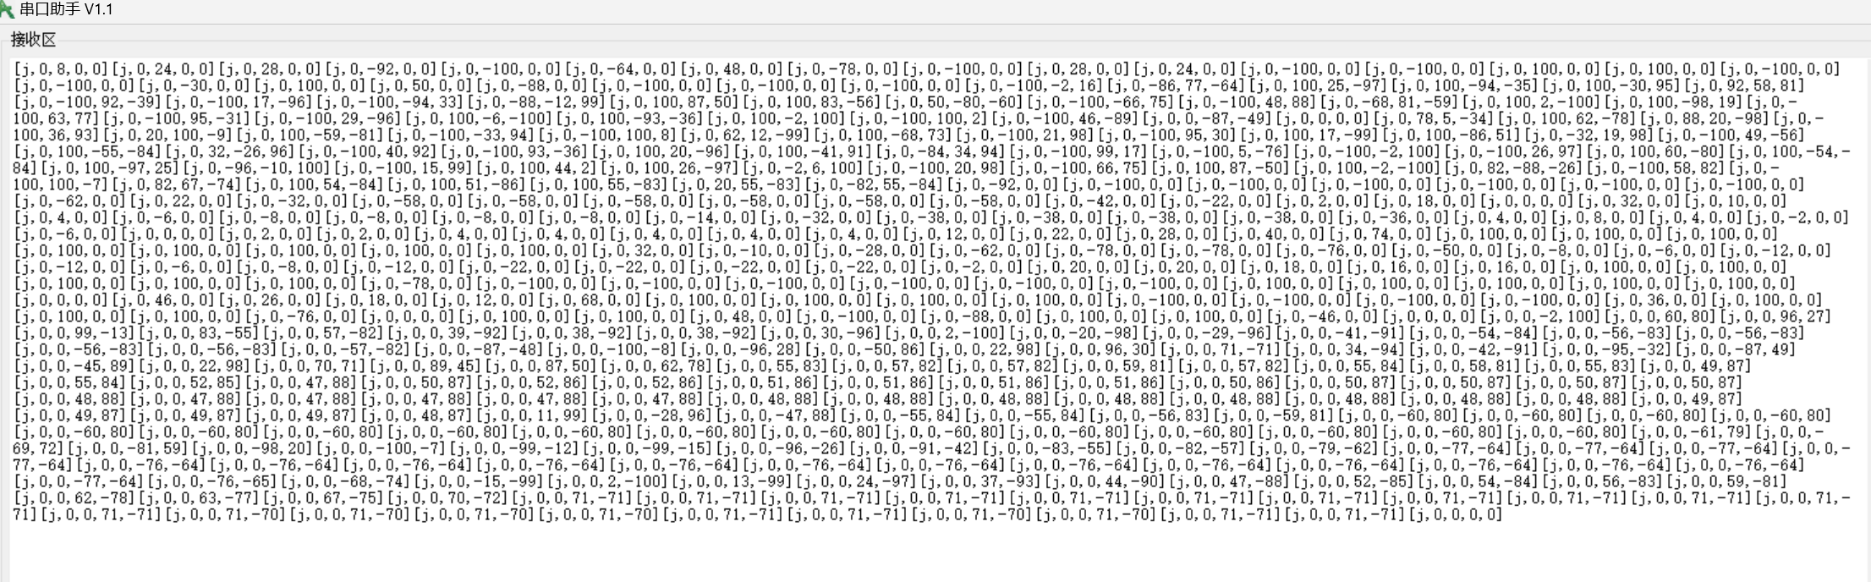
source/蓝牙串口信息/42b49e189cae356d66ca0799c48181c1.png
