Muzhixing/MCU-slave-device/source/蓝牙串口信息/d82d04c01185371e8665aecb59ed1f2d.jpg

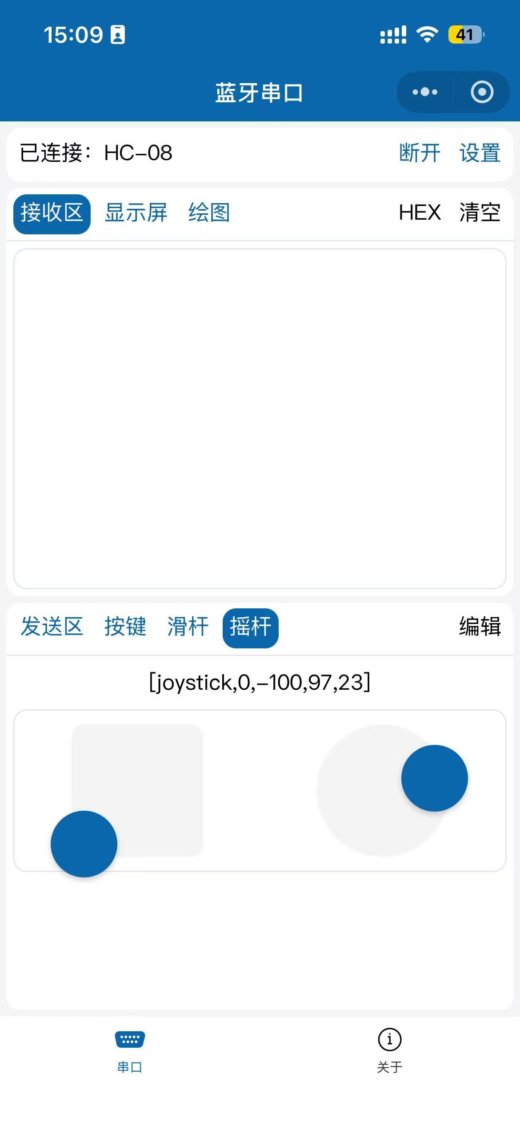
source/蓝牙串口信息/d82d04c01185371e8665aecb59ed1f2d.jpg
