Muzhixing/MCU-slave-device/source/word(3).xlsx

名称 | 价格 | 总计
无声轻触按键（10只） | 2.74
USB3.1 | 2.43
M3*10（100只） | 3.52
TB6612FNG | 6.51
M4*25（20只） | 3.21
6P单排（20只） | 2.71
UMW/友台 LM2596S-5.0V TO263-5 | 3.4
6p弯针+端子+插座（50套） | 8.2
金属齿轮升级款舵机 MG90S（90-180自由角度 | 15.86
2p直针+端子+插座（50套） | 2.82
阻燃宽19mm*厚0.3mm*15米 | 5.07
M3*6带垫螺丝（100只） | 3.35
4P单排（20只） | 2.32
HLK-B0303S-1WR3【3.3V转3.3V】高效率/短路保护 | 4.84
25P双排（5只） | 2.12
3P双排（20只） | 2.71
8P单排（20只） | 3.03
0630电感33UH 印字330（5只） | 2.7
M4*10（20只） | 2.81
3V有源小型一体0905电磁式（2只） | 2.31
4P双排（20只） | 2.93
1N5824贴片SMA丝印SS54（10只） | 2.01
M3*17 (50个) | 8.5
M3*55 (20个) | 14.7
石英晶振32.768M（10个） | 5.14
120Ω;±1%;50只 | 1
TYPE-C-31-M-12 | 3.5
B0524S-1WR3 | 2.6
CH340E MSOP-10 | 2.4
STM32F103RET6 | 15
贴片 TJA1050T/CM | 2.99
XT60PW-F（母头） | 2.7
800mAh 45C【升级款】;3S【XT60插 | 49.3
双模天线SMA | 8
 | 203.43
 | 203.43-30=173.43‬
