Muzhixing/MCU-slave-device/new_project_f407/F407_HAL_Template/docs/validation/host-tests.txt

PASS packet framing/encoding/resync, independent origins, repeated targets, axis/chassis sequencing, yaw hold/correction, reverse brake, disable, sensor/comms/motor faults, telemetry checksum
