Muzhixing/MCU-slave-device/new_project_f407/F407_HAL_Template/docs/validation/README.md

# 2026-10-26 清理后验证

- Keil ARMCC 5.06u5 build528 全量Rebuild：0错误、0警告。
- Code=17588，RO=564，RW=184，ZI=6968字节。
- Keil工程XML及全部文件引用存在、无重复路径。
- GCC C99 `-Wall -Wextra -Werror`：协议/状态机/脉冲模块主机回归通过。
- 测试覆盖解析重同步、有符号编码、零点门控、重复绝对目标、轴/底盘互斥、航向保持、反向等待、停止和故障回报。

详见build.log和host-tests.txt。没有执行本次清理版的硬件烧录或实机回归；用户已确认的是清理前整合数据包成功。固件见../../firmware，SHA256与发布文件一致。
