Muzhixing/MCU-slave-device/source/STM32F103C8T6D485-2.pdf

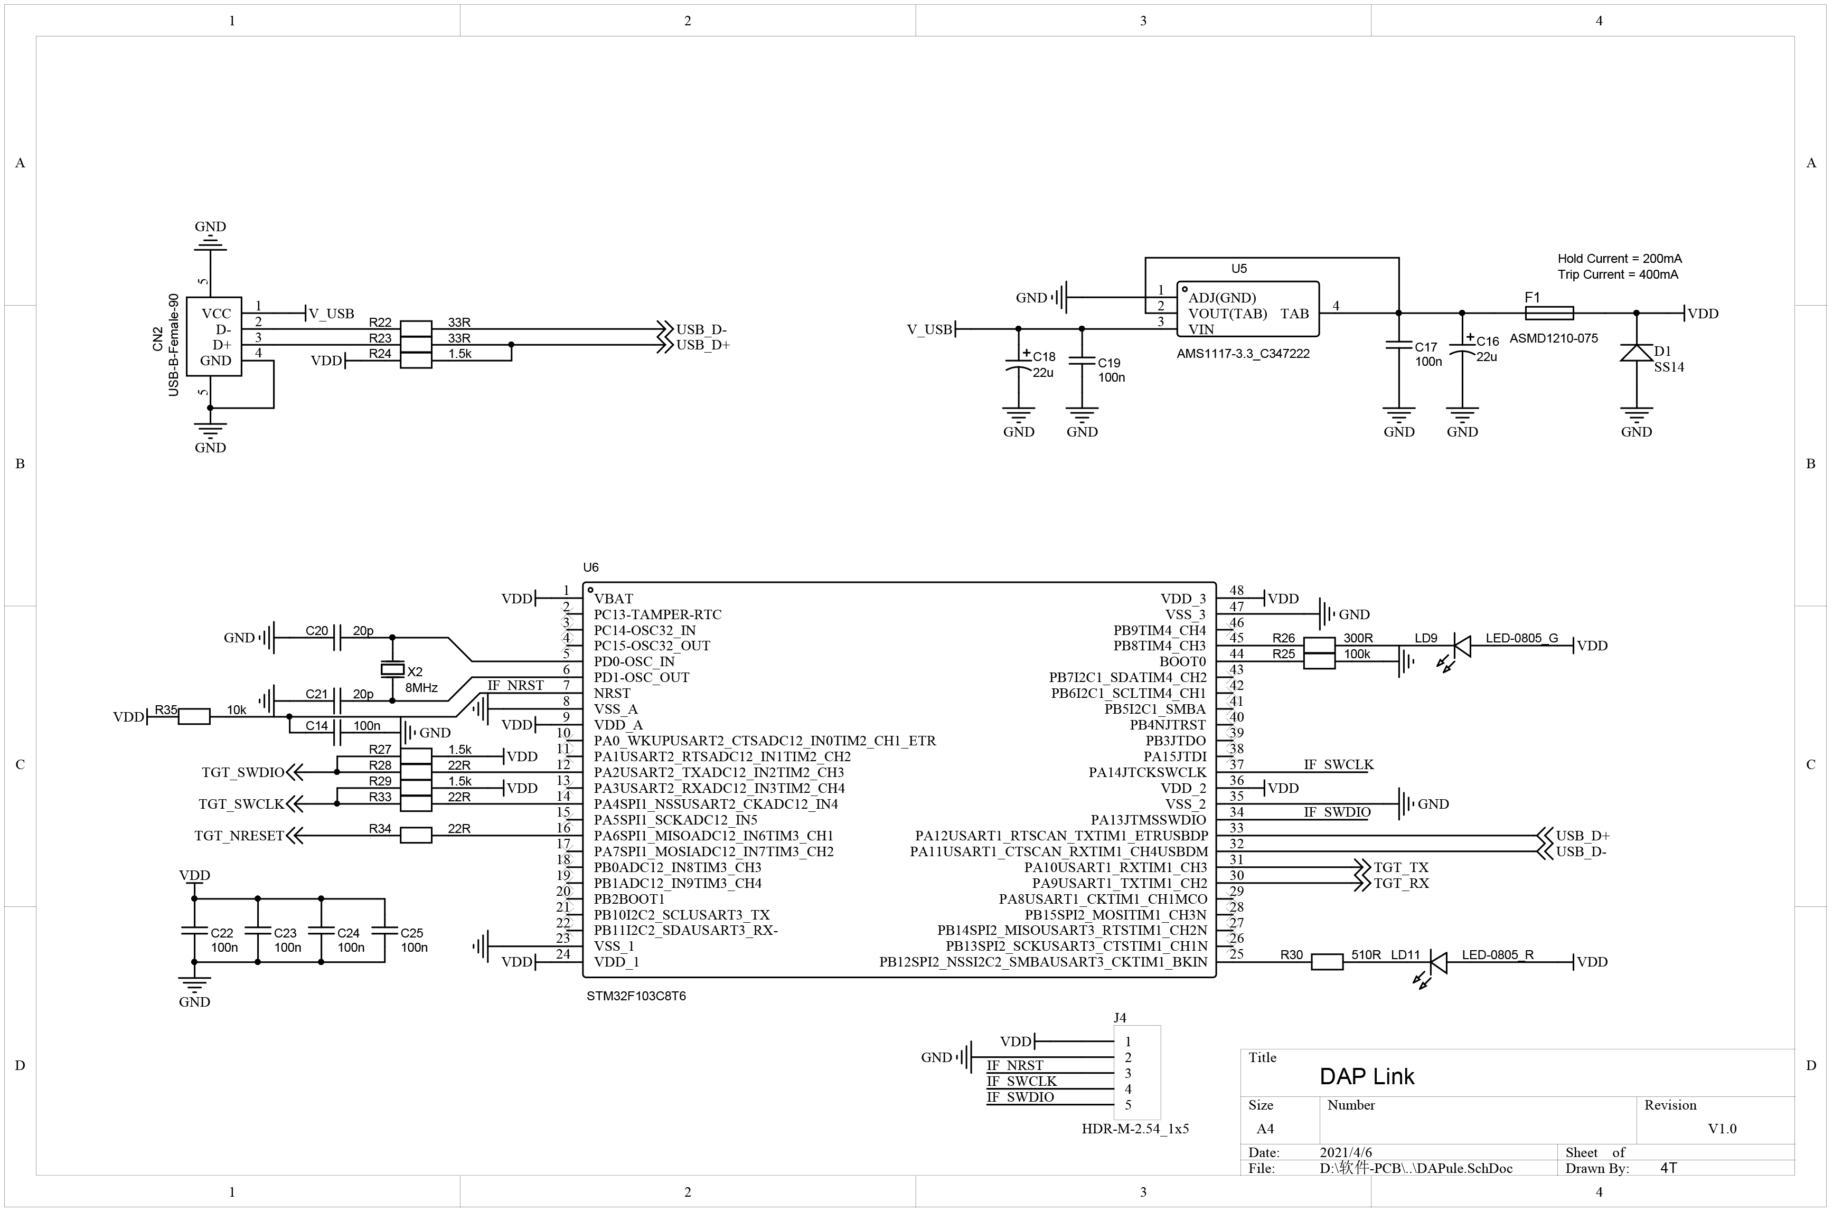
[picture p26: page 1]
