Muzhixing/MCU-slave-device/source/原理图/STM32F103C8T6D485-2.pdf

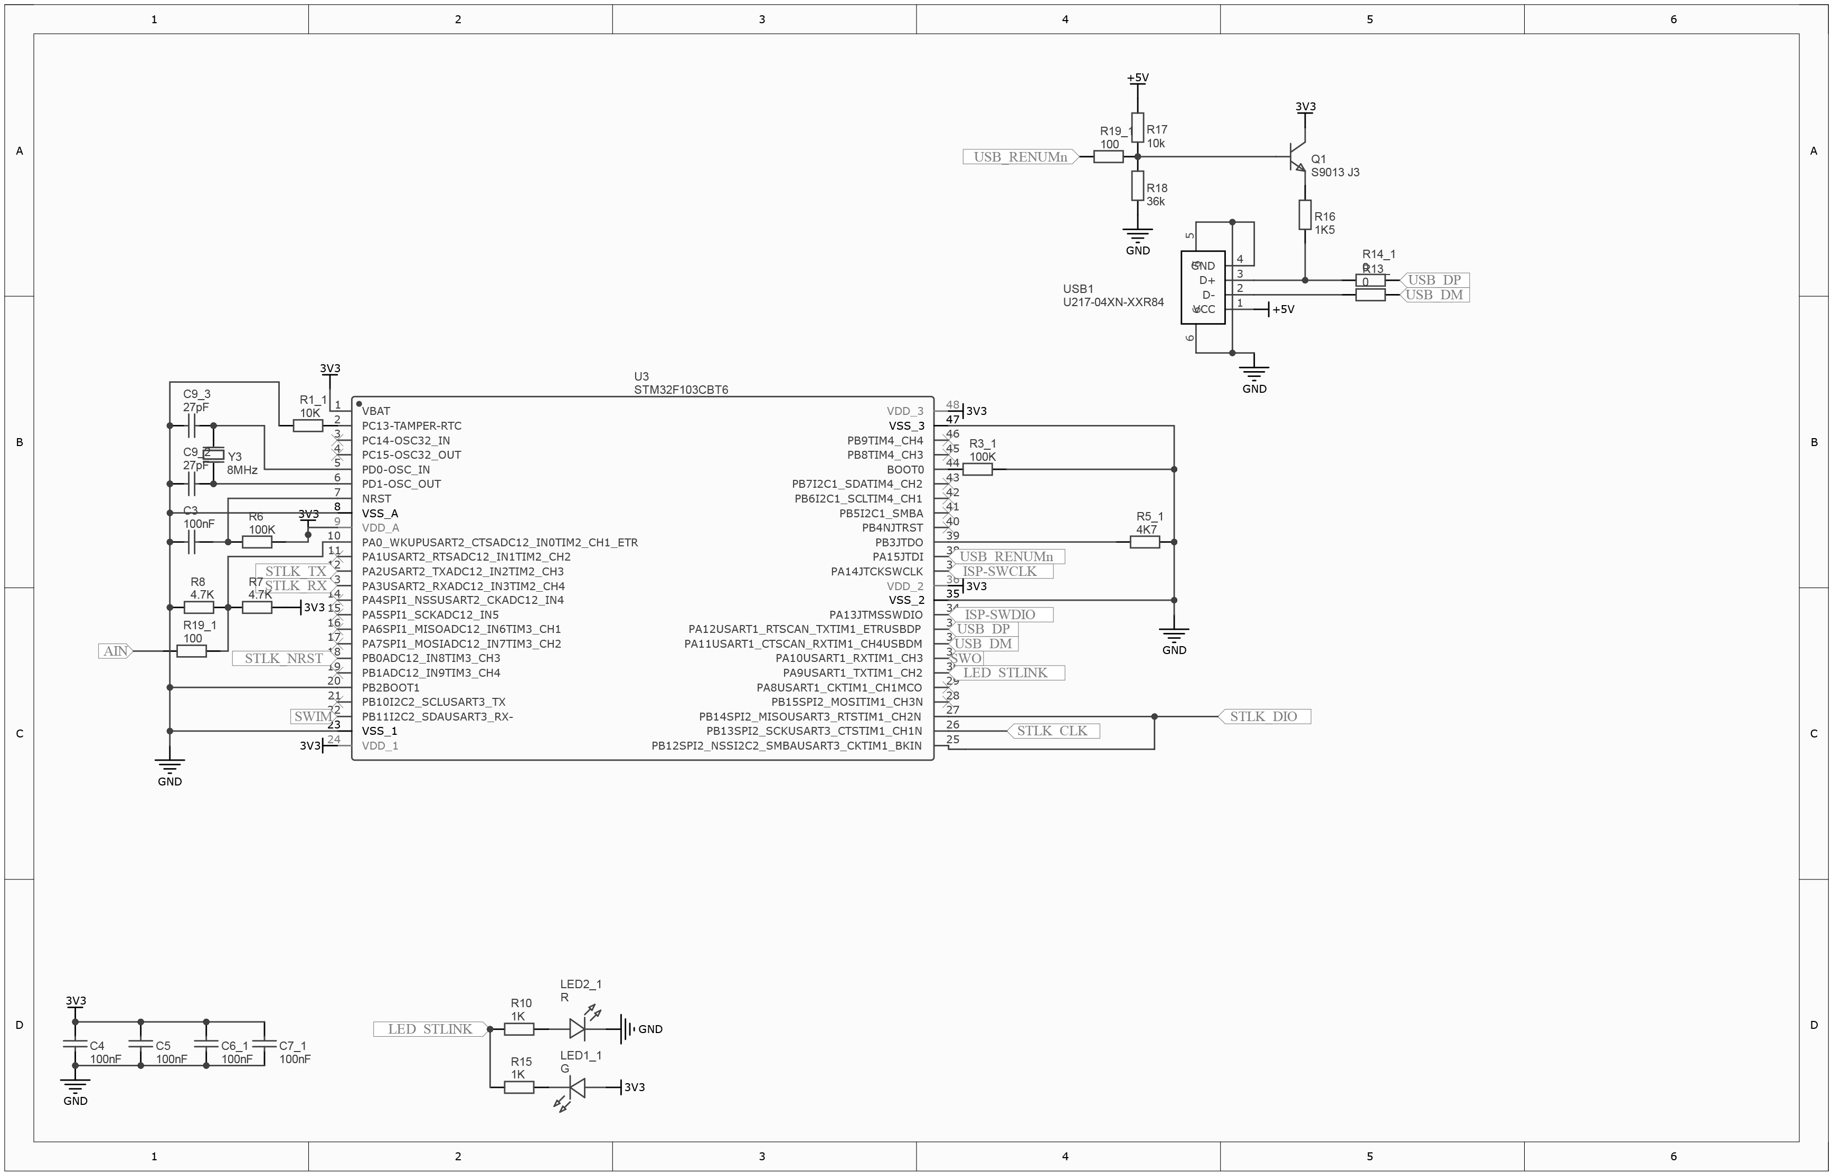
[picture p27: page 1]
