Muzhixing/MCU-slave-device/src/Hardwaer/PID.h

#ifndef __PID_H
#define __PID_H
#include"stdint.h"
#include "string.h"
#include "main.h"
//#include "Servo.h"
#include "stdint.h"
void pid_S_Y(float true_S, float tar_S);
void pid_S_X(float true_S, float tar_S);


#endif
