Muzhixing/MCU-slave-device/src/Hardwaer/hardware.h

#ifndef __HARDWARE_H__
#define __HARDWARE_H__

/* ===========================================================================
 * 统一硬件头文件管理系统
 * ===========================================================================
 * 功能：集中管理 hardware 目录下所有硬件模块的头文件引用
 * 说明：
 *   - 所有硬件相关源文件只需包含此文件即可获取所需的全部硬件接口定义
 *   - 使用 #ifndef/#define/#endif 防止头文件重复包含
 *   - 按功能模块分类组织头文件
 * =========================================================================== */

/* ===========================================================================
 * 第一部分：标准库和基础类型
 * =========================================================================== */
#include <stdint.h>
#include <stdbool.h>
#include <string.h>
#include <stdio.h>
#include <stdlib.h>

/* ===========================================================================
 * 第二部分：STM32 HAL 库和芯片相关头文件
 * =========================================================================== */
#include "main.h"
#include "usart.h"
#include "tim.h"
#include "can.h"
/* ===========================================================================
 * 第三部分：底层驱动接口（CAN/UART/I2C/SPI/GPIO/TIM）
 * =========================================================================== */

/* ===========================================================================
 * 第四部分：核心电机和运动控制模块
 * =========================================================================== */
#include "motor.h"
#include "mulun.h"
#include "Servo.h"
#include "can.h"
#include "Emm_V5.h"
/* ===========================================================================
 * 第五部分：电机驱动和功率控制模块
 * =========================================================================== */
#include "Emm_V5.h"
//#include "tower.h"
#include "tower.h"
/* ===========================================================================
 * 第六部分：控制算法模块（PID/状态机）
 * =========================================================================== */
#include "PID.h"
#include "State_Machine.h"

/* ===========================================================================
 * 第七部分：执行器模块（舵机/编码器）
 * =========================================================================== */
//#include "Servo.h"

/* ===========================================================================
 * 第八部分：传感器模块
 * =========================================================================== */
#include "wt101.h"
#include "ultrasound.h"
#include "water_pump.h"
#include "milk_monitor.h"

/* ===========================================================================
 * 第九部分：板级初始化和辅助模块
 * =========================================================================== */
//#include "board.h"
//#include "urat_data_taclk.h"

/* ===========================================================================
 * 第十部分：显示模块（OLED）
 * =========================================================================== */


#endif /* __HARDWARE_H__ */
