Muzhixing/MCU-slave-device/(commit log)

2026-09-07 CAN钢丝电机控制实验
2026-09-08 蓝牙双步进电机控制测试
2026-09-09 docs: plan HWT101 I2C migration
2026-09-10 整合正式状态机并记录当前工程状态
2026-10-26 整理F407整合工程、硬件接线、串口协议与测试记录
