Muzhixing/MCU-slave-device/(notices)

Notices in the files:
source/keil测试工程/Core/Inc/main.h:
Copyright (c) 2022 STMicroelectronics.
All rights reserved.
This software is licensed under terms that can be found in the LICENSE file
